Simgag-MinEnv/DEHCam/Extras/HW/imgs/20210331_120226.jpg

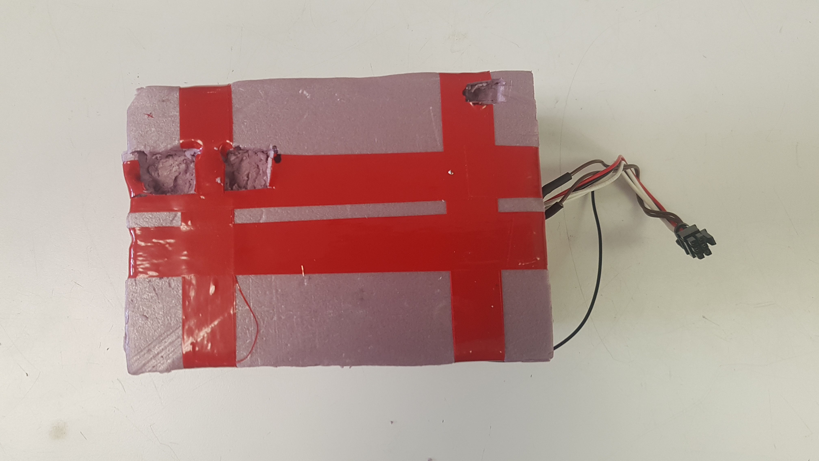
Extras/HW/imgs/20210331_120226.jpg
