Simgag-MinEnv/DEHCam/Extras/HW/imgs/20210331_115955.jpg

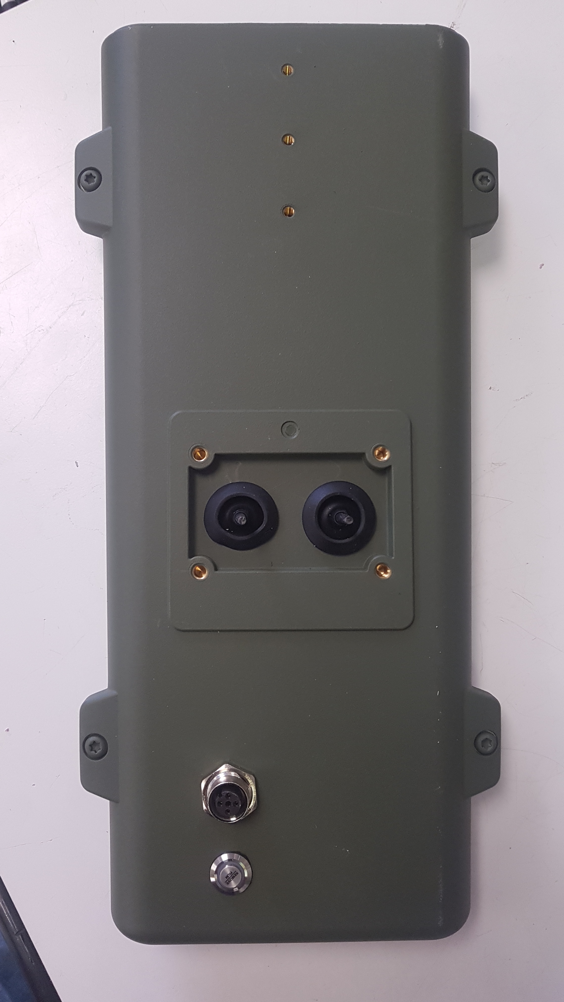
Extras/HW/imgs/20210331_115955.jpg
