Simgag-MinEnv/DEHCam/README.md

# DEHCam
A fully autonomous LTE field camera
