Simgag-MinEnv/DEHCam/Extras/HW/imgs/20210331_115628.jpg

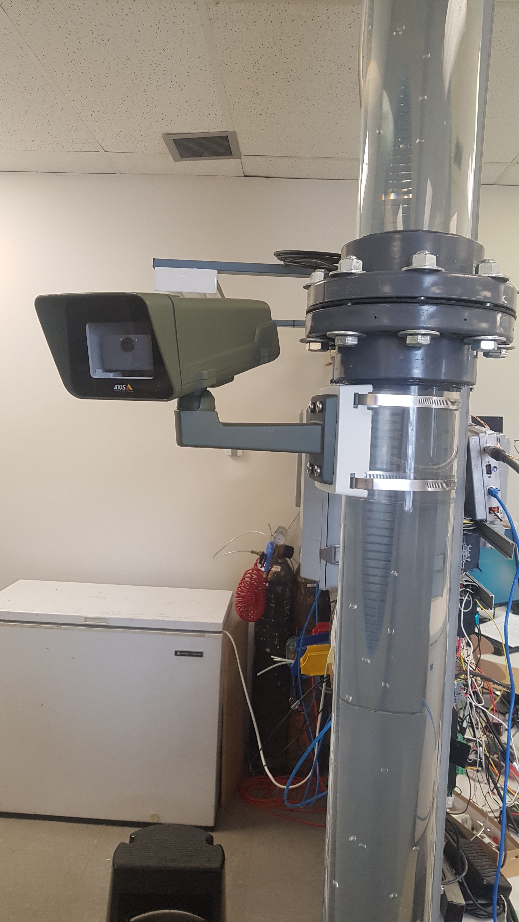
Extras/HW/imgs/20210331_115628.jpg
