Simgag-MinEnv/DEHCam/Extras/HW/imgs/20210331_115636.jpg

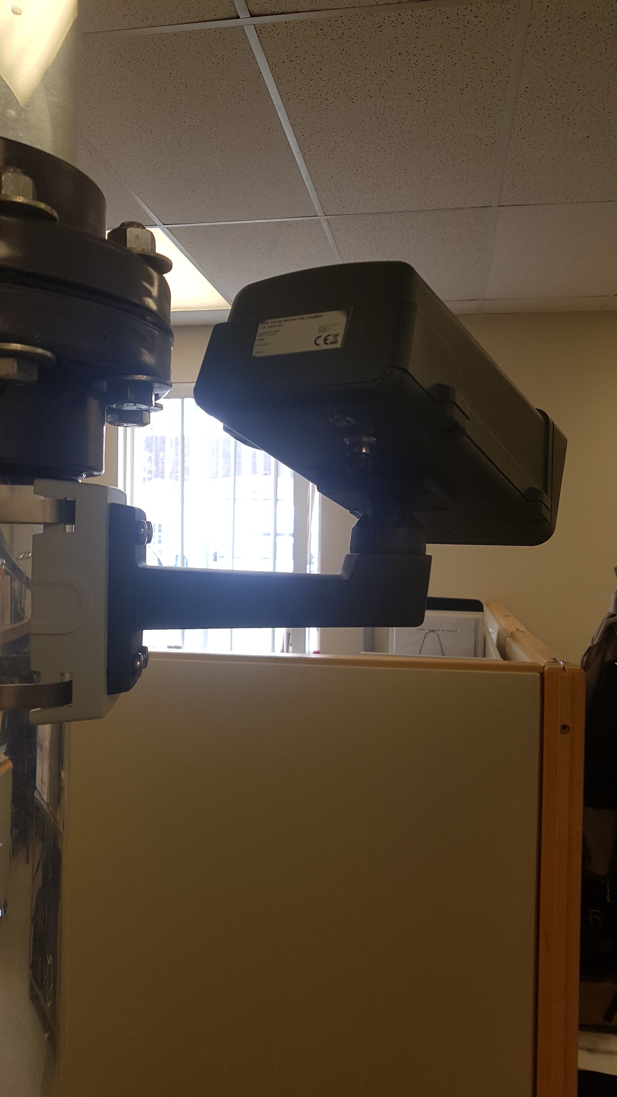
Extras/HW/imgs/20210331_115636.jpg
