Simgag-MinEnv/DEHCam/Extras/HW/imgs/20210331_115641.jpg

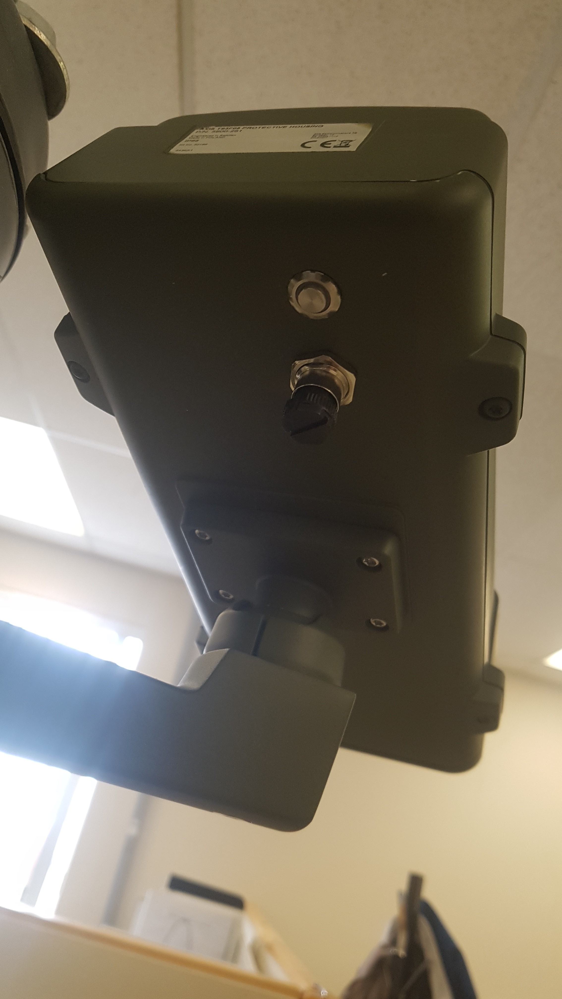
Extras/HW/imgs/20210331_115641.jpg
