Simgag-MinEnv/DEHCam/Extras/HW/imgs/20210331_115650.jpg

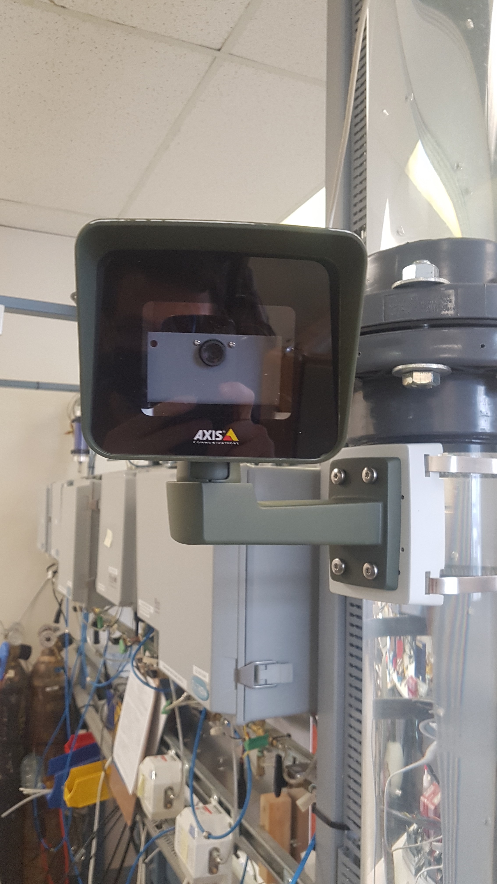
Extras/HW/imgs/20210331_115650.jpg
