Simgag-MinEnv/DEHCam/Extras/HW/imgs/20210331_120000.jpg

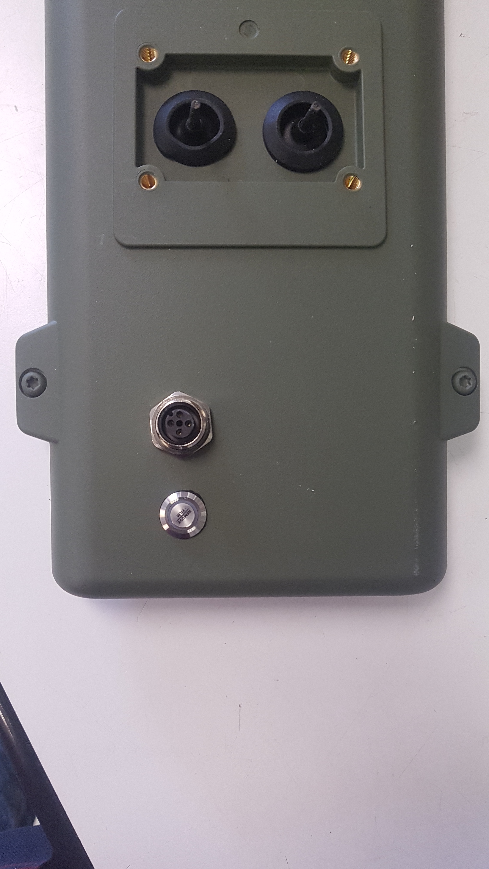
Extras/HW/imgs/20210331_120000.jpg
