Simgag-MinEnv/DEHCam/Extras/HW/imgs/20210331_120005.jpg

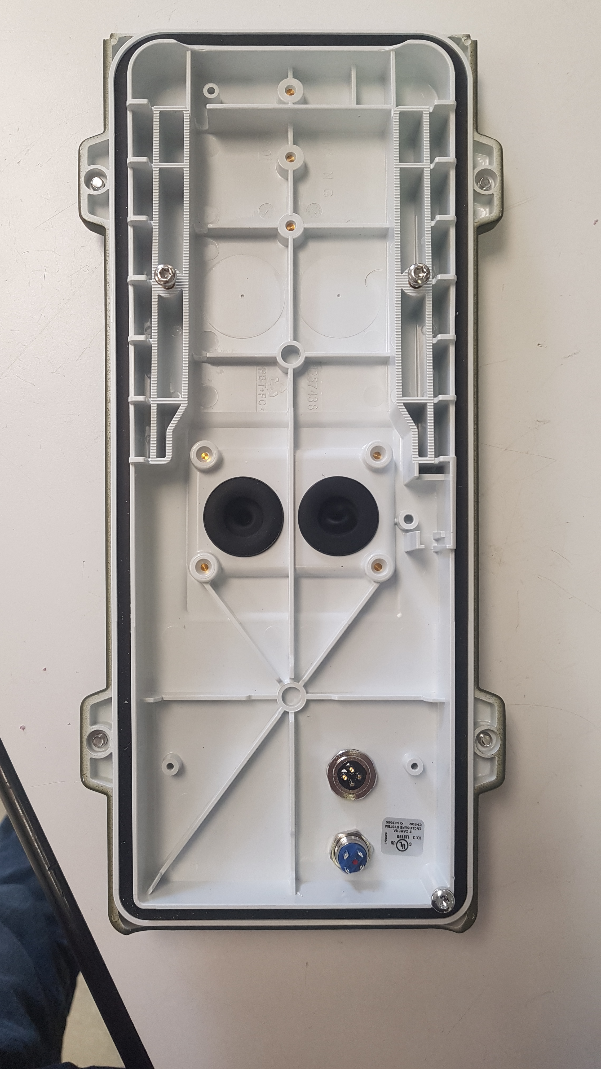
Extras/HW/imgs/20210331_120005.jpg
