Simgag-MinEnv/DEHCam/Extras/HW/imgs/20210331_120015.jpg

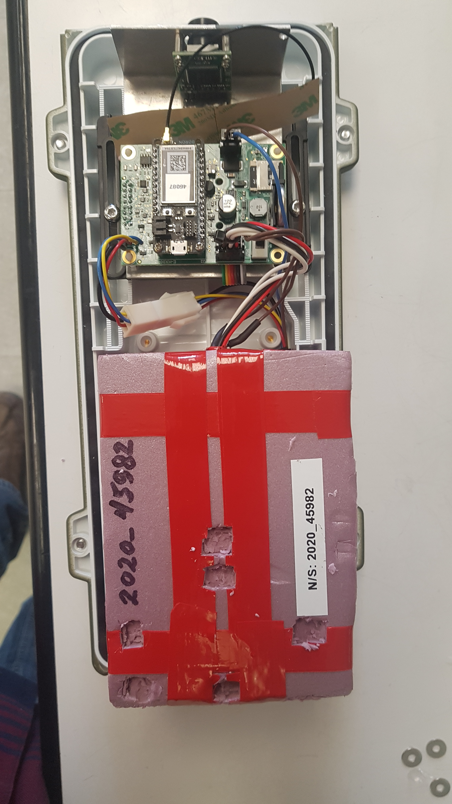
Extras/HW/imgs/20210331_120015.jpg
