Simgag-MinEnv/DEHCam/Extras/HW/imgs/20210331_120052.jpg

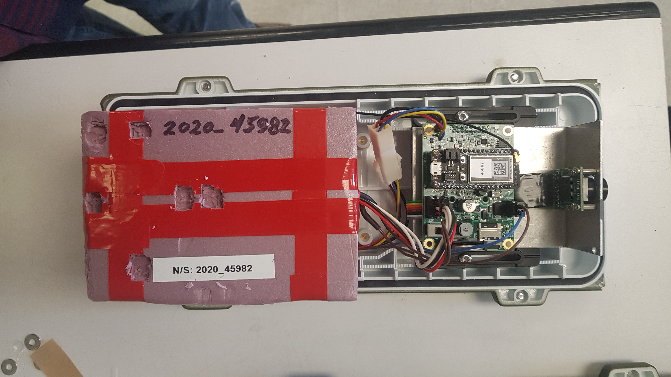
Extras/HW/imgs/20210331_120052.jpg
