Simgag-MinEnv/DEHCam/Extras/HW/imgs/20210331_120108.jpg

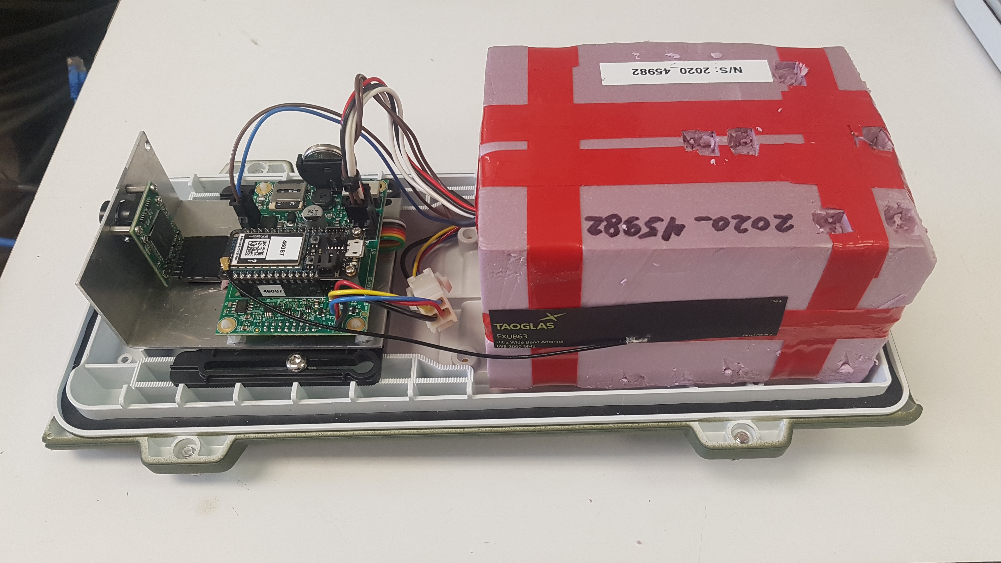
Extras/HW/imgs/20210331_120108.jpg
