Simgag-MinEnv/DEHCam/Extras/HW/imgs/20210331_120122.jpg

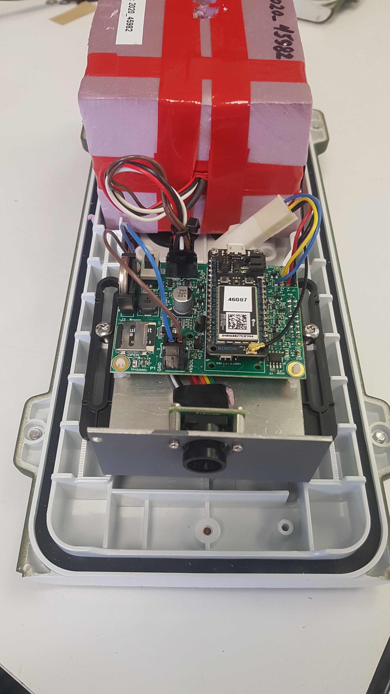
Extras/HW/imgs/20210331_120122.jpg
