Simgag-MinEnv/DEHCam/Extras/HW/imgs/20210331_120146.jpg

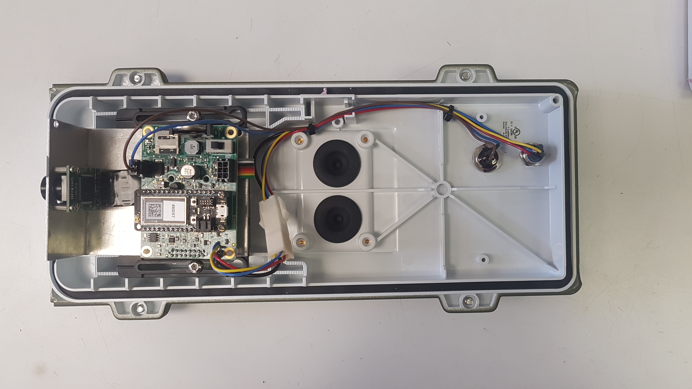
Extras/HW/imgs/20210331_120146.jpg
