Simgag-MinEnv/DEHCam/Extras/HW/imgs/20210331_120150.jpg

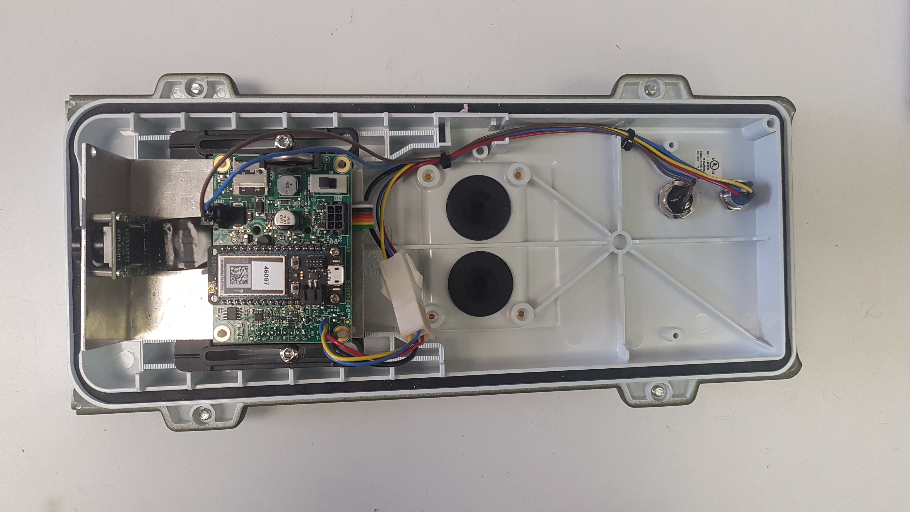
Extras/HW/imgs/20210331_120150.jpg
