Simgag-MinEnv/DEHCam/Extras/HW/imgs/20210331_120212.jpg

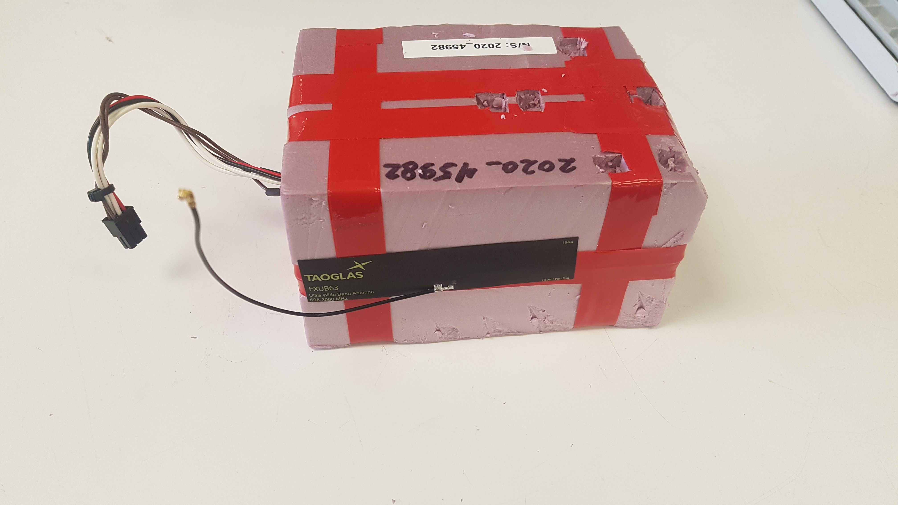
Extras/HW/imgs/20210331_120212.jpg
