Simgag-MinEnv/DEHCam/Extras/HW/imgs/20210331_120219.jpg

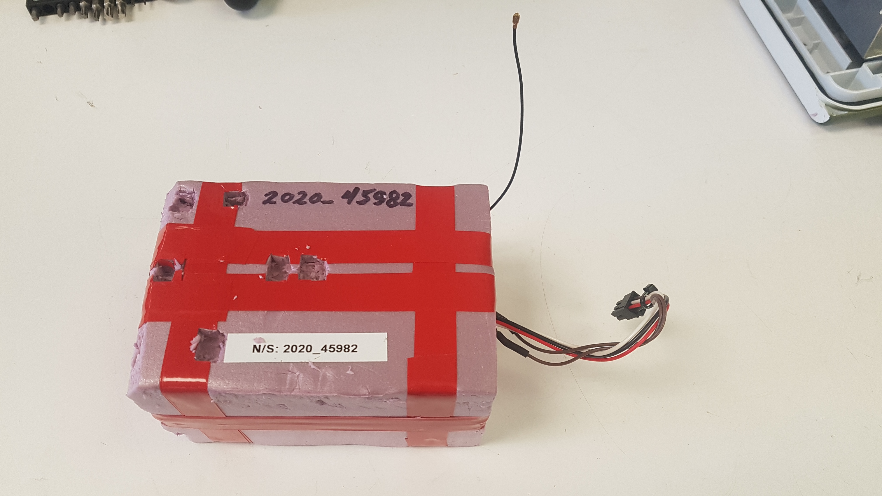
Extras/HW/imgs/20210331_120219.jpg
