Simgag-MinEnv/DEHCam/Extras/HW/imgs/20210331_150757.jpg

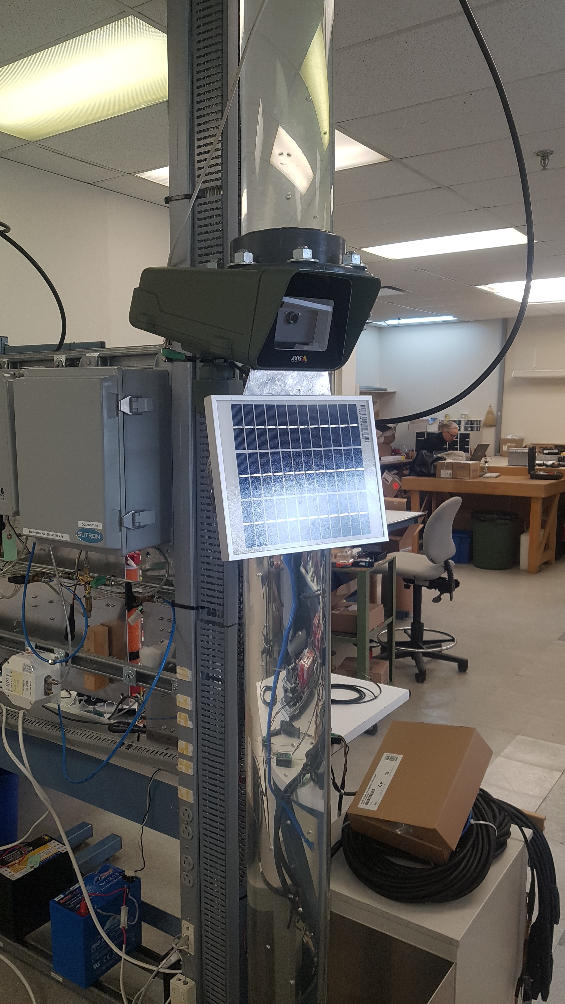
Extras/HW/imgs/20210331_150757.jpg
