Simgag-MinEnv/DEHCam/Extras/HW/imgs/20210331_150813.jpg

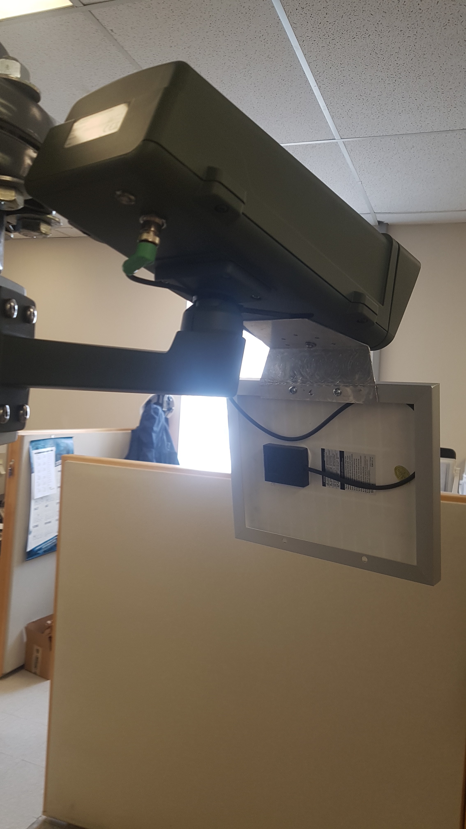
Extras/HW/imgs/20210331_150813.jpg
