Simgag-MinEnv/DEHCam/Extras/Man/Fr/img/BattAssy.png

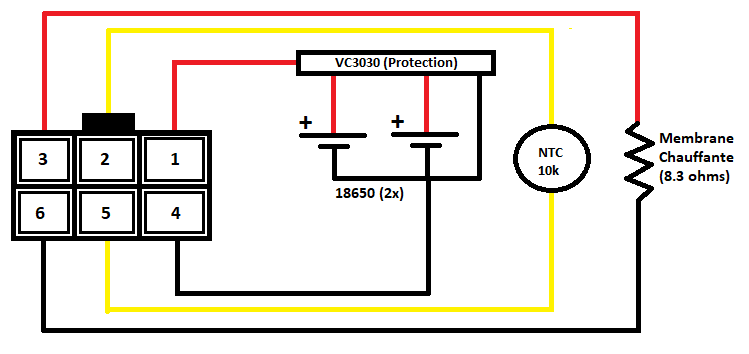
Extras/Man/Fr/img/BattAssy.png
