Simgag-MinEnv/DEHCam/Extras/Man/Fr/img/Boron_SIM.jpg

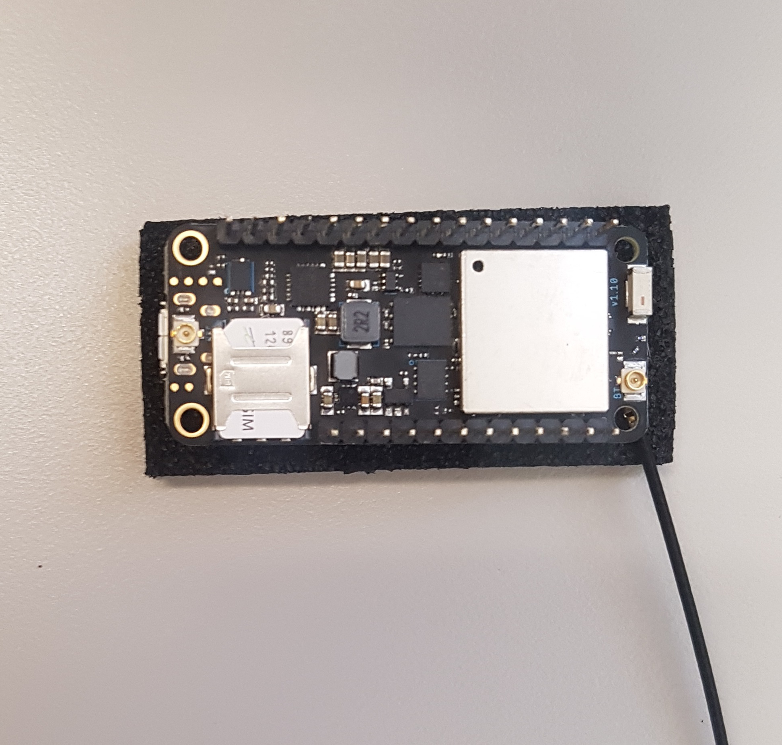
Extras/Man/Fr/img/Boron_SIM.jpg
