Simgag-MinEnv/DEHCam/Extras/Man/Fr/img/BoronBelow.jpg

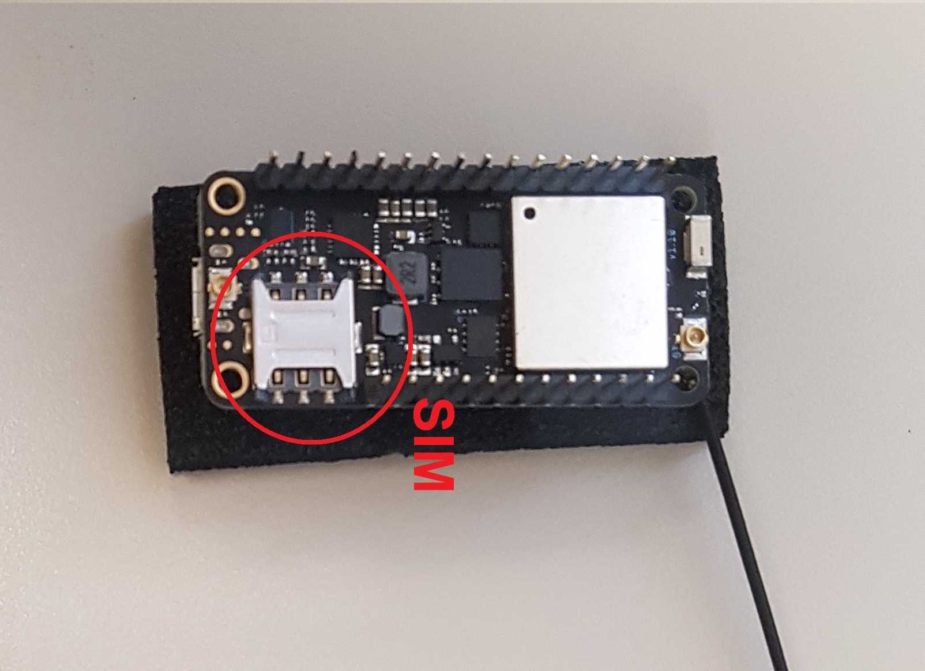
Extras/Man/Fr/img/BoronBelow.jpg
