Simgag-MinEnv/DEHCam/Extras/Man/Fr/img/Cam_final.jpg

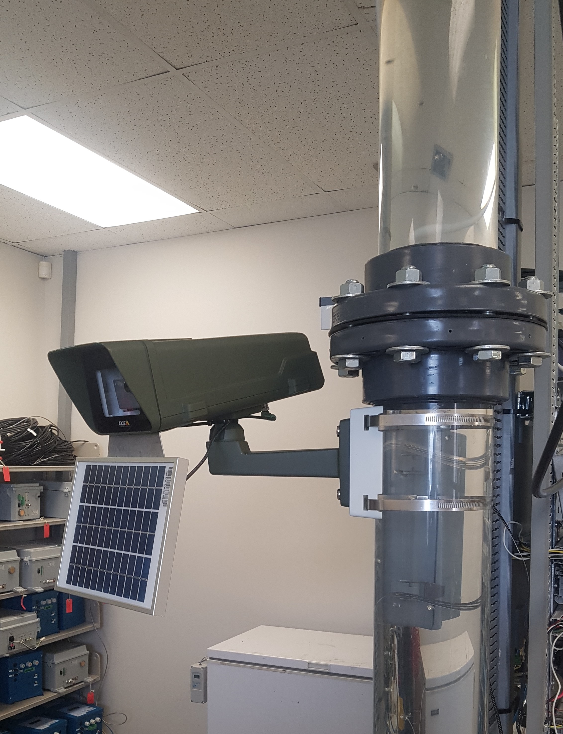
Extras/Man/Fr/img/Cam_final.jpg
