Simgag-MinEnv/DEHCam/Extras/Man/Fr/img/CloudDeviceDetail.png

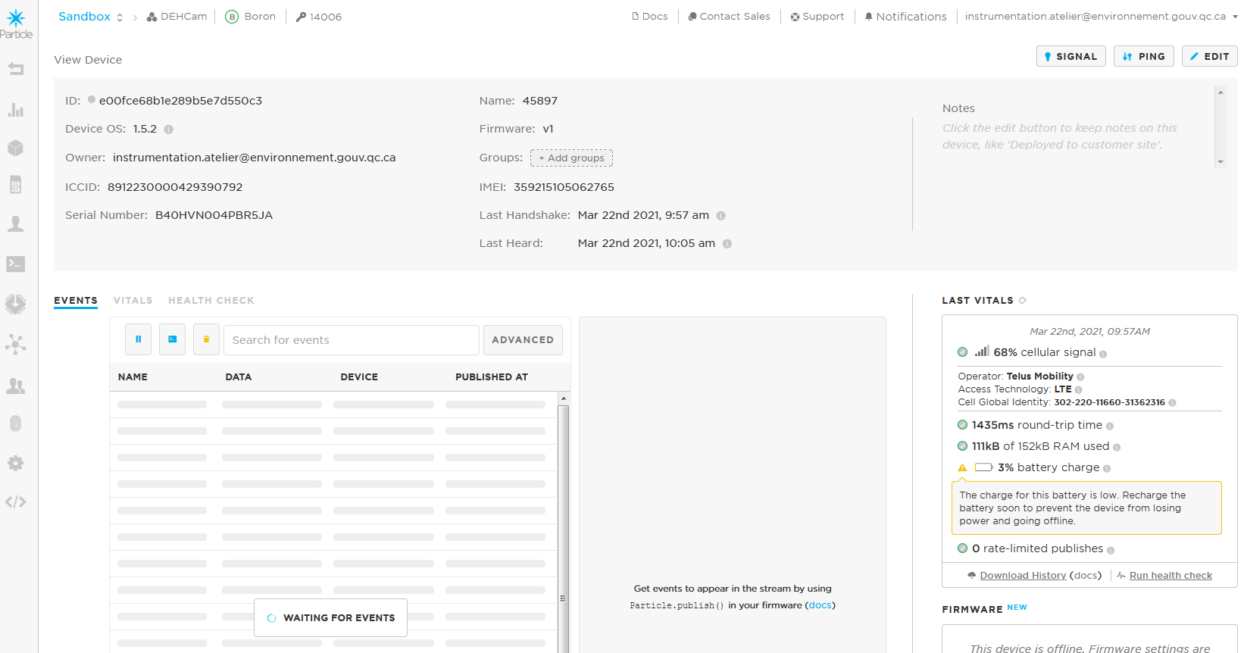
Extras/Man/Fr/img/CloudDeviceDetail.png
