Simgag-MinEnv/DEHCam/Extras/Man/Fr/img/CloudDevices.png

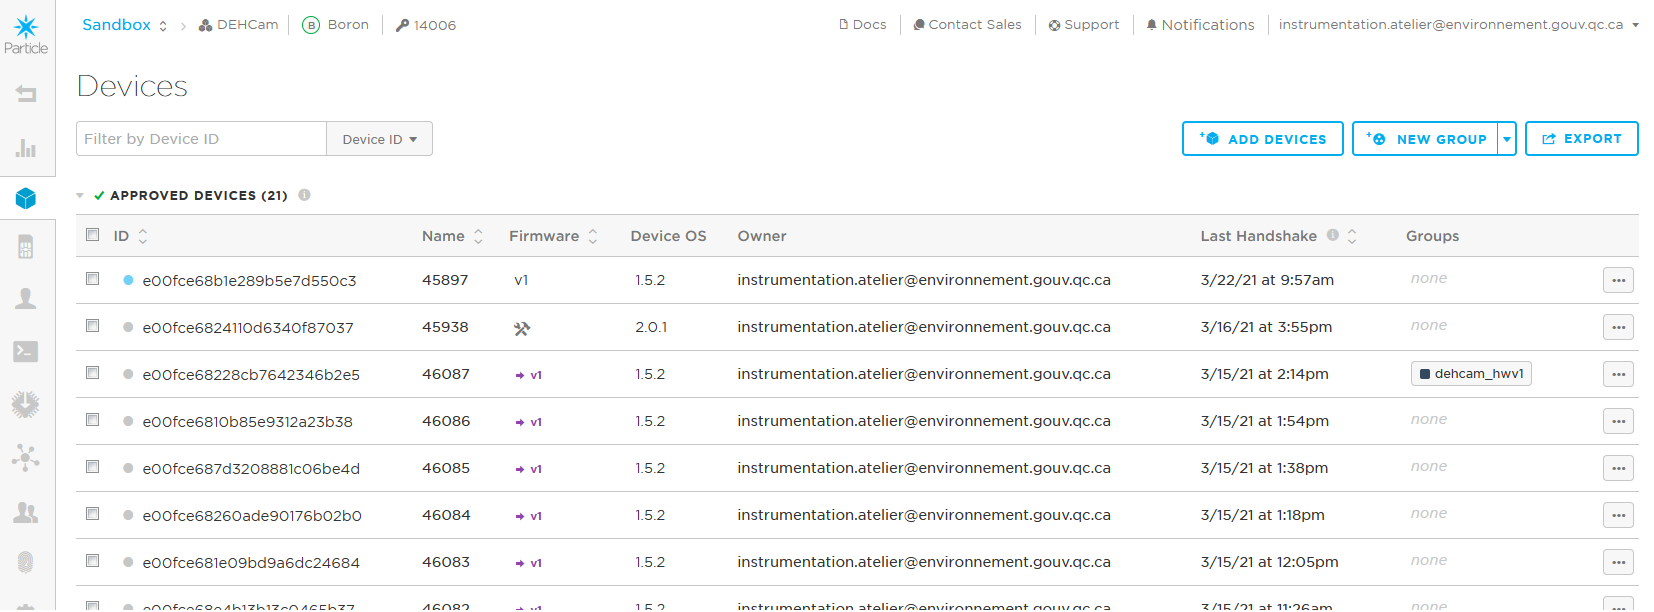
Extras/Man/Fr/img/CloudDevices.png
