Simgag-MinEnv/DEHCam/Extras/Man/Fr/img/CloudFirmwares.png

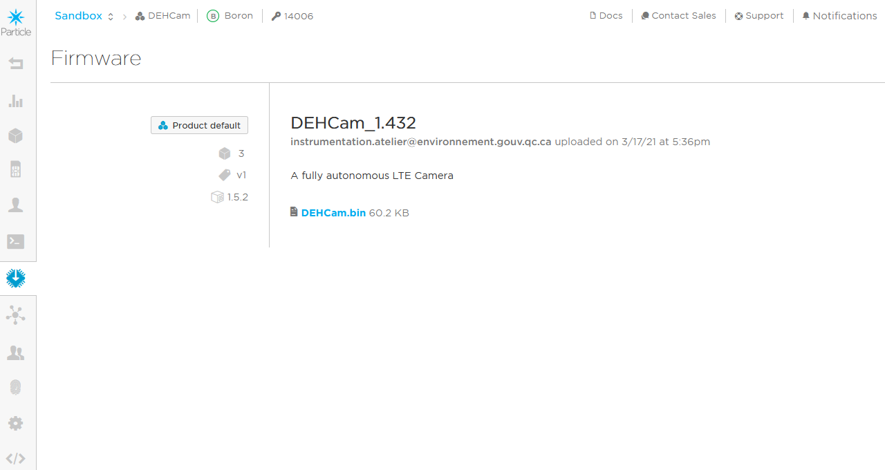
Extras/Man/Fr/img/CloudFirmwares.png
