Simgag-MinEnv/DEHCam/Extras/Man/Fr/img/CloudProducts.png

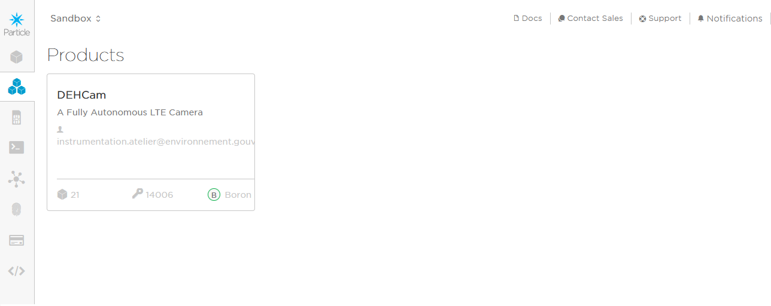
Extras/Man/Fr/img/CloudProducts.png
