Simgag-MinEnv/DEHCam/Extras/Man/Fr/img/CloudUsers.png

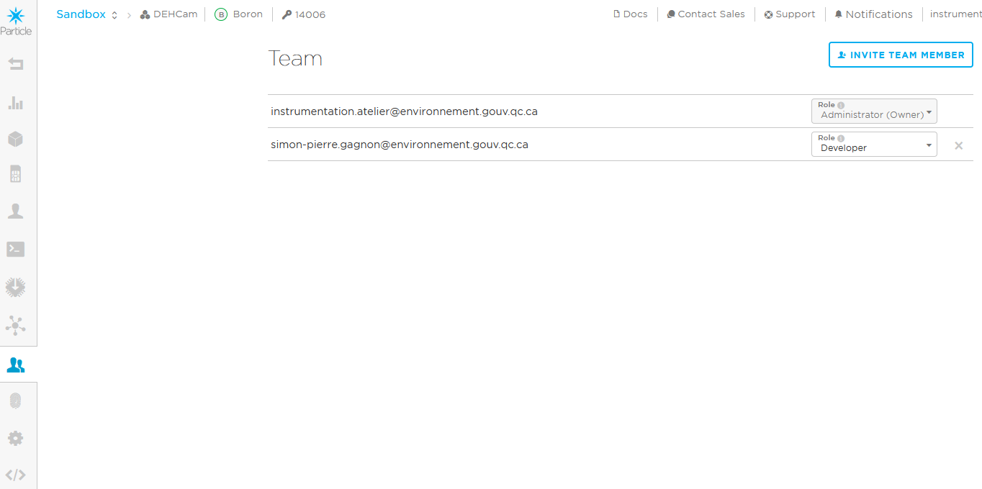
Extras/Man/Fr/img/CloudUsers.png
