Simgag-MinEnv/DEHCam/Extras/Man/Fr/img/exif.png

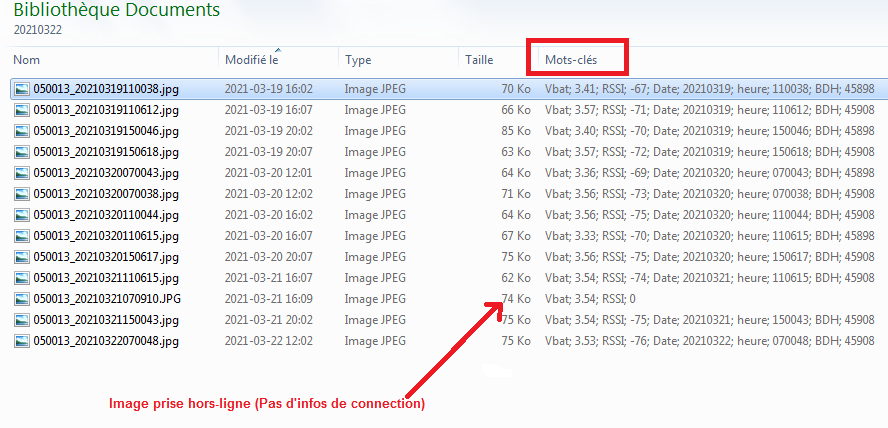
Extras/Man/Fr/img/exif.png
