Simgag-MinEnv/DEHCam/Extras/Man/Fr/img/IAM.PNG

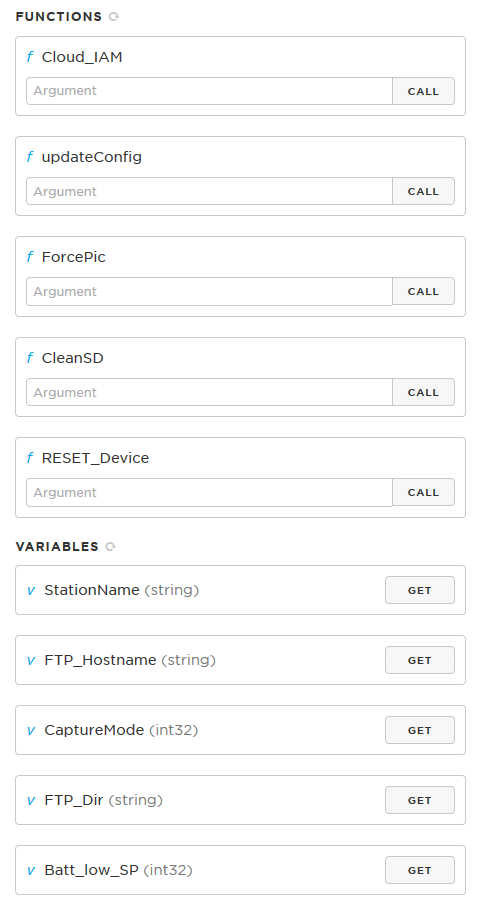
Extras/Man/Fr/img/IAM.PNG
