Simgag-MinEnv/DEHCam/Extras/Man/Fr/img/MB_1.png

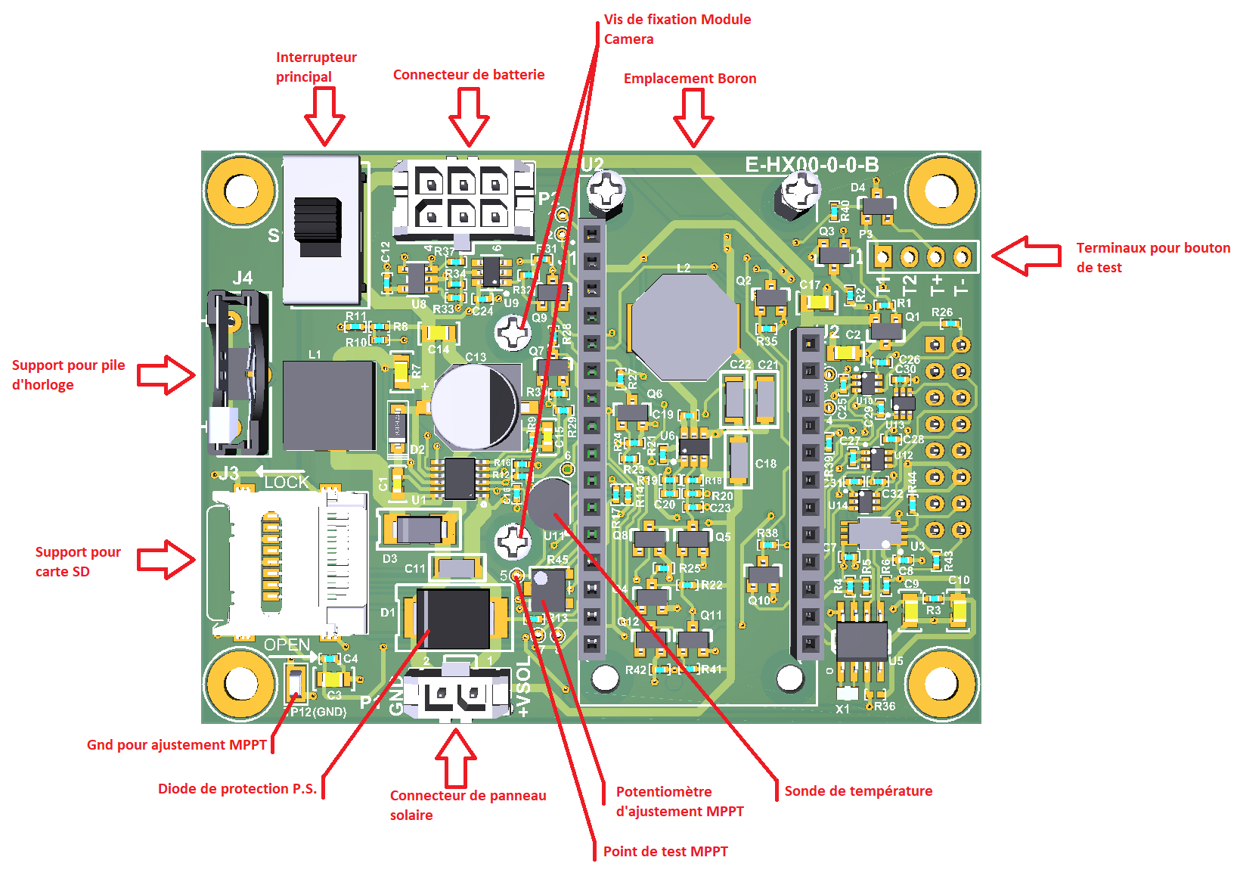
Extras/Man/Fr/img/MB_1.png
