Simgag-MinEnv/DEHCam/Extras/Man/Fr/img/MB_2.png

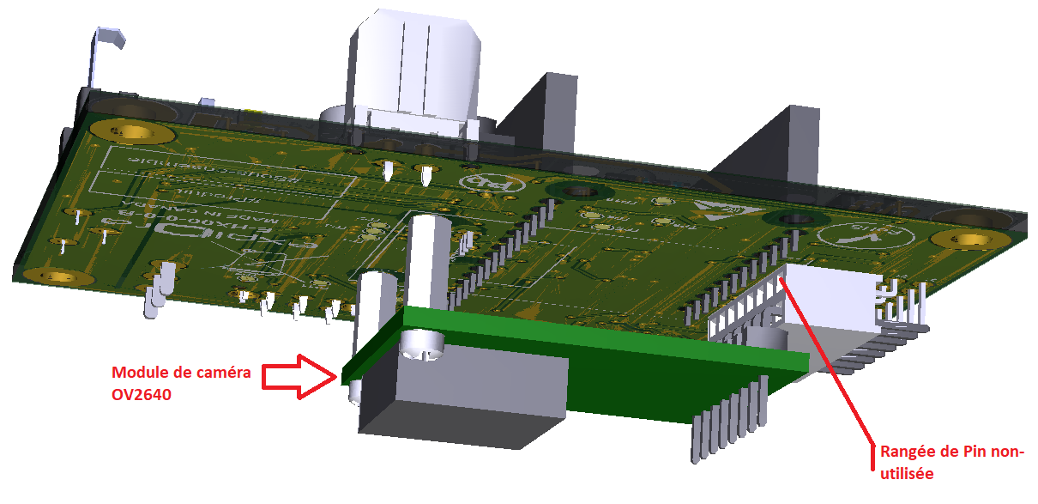
Extras/Man/Fr/img/MB_2.png
