Simgag-MinEnv/DEHCam/Extras/Man/Fr/img/Percements_boitier.jpg

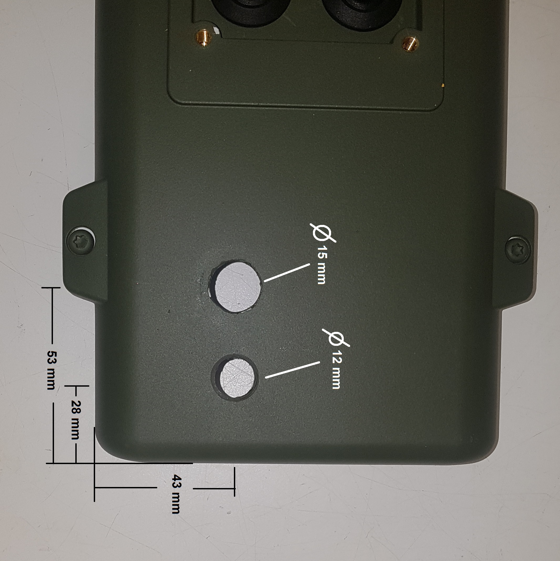
Extras/Man/Fr/img/Percements_boitier.jpg
