Simgag-MinEnv/DEHCam/Extras/Man/Fr/img/PlaqueSupport.png

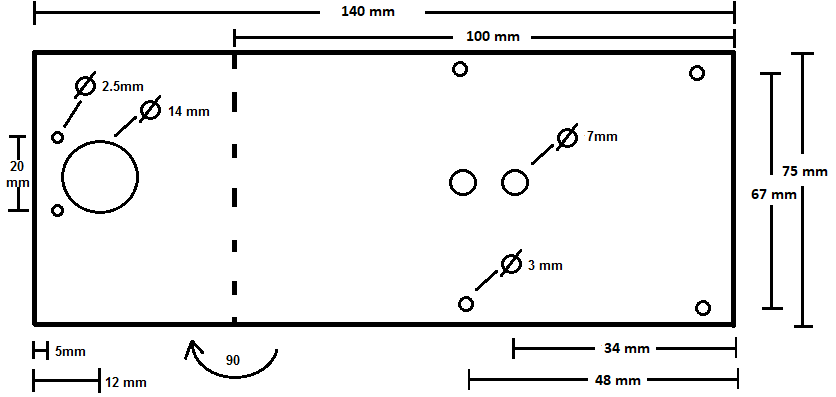
Extras/Man/Fr/img/PlaqueSupport.png
