Simgag-MinEnv/DEHCam/Extras/Man/Fr/img/schema_fonctionnel.jpg

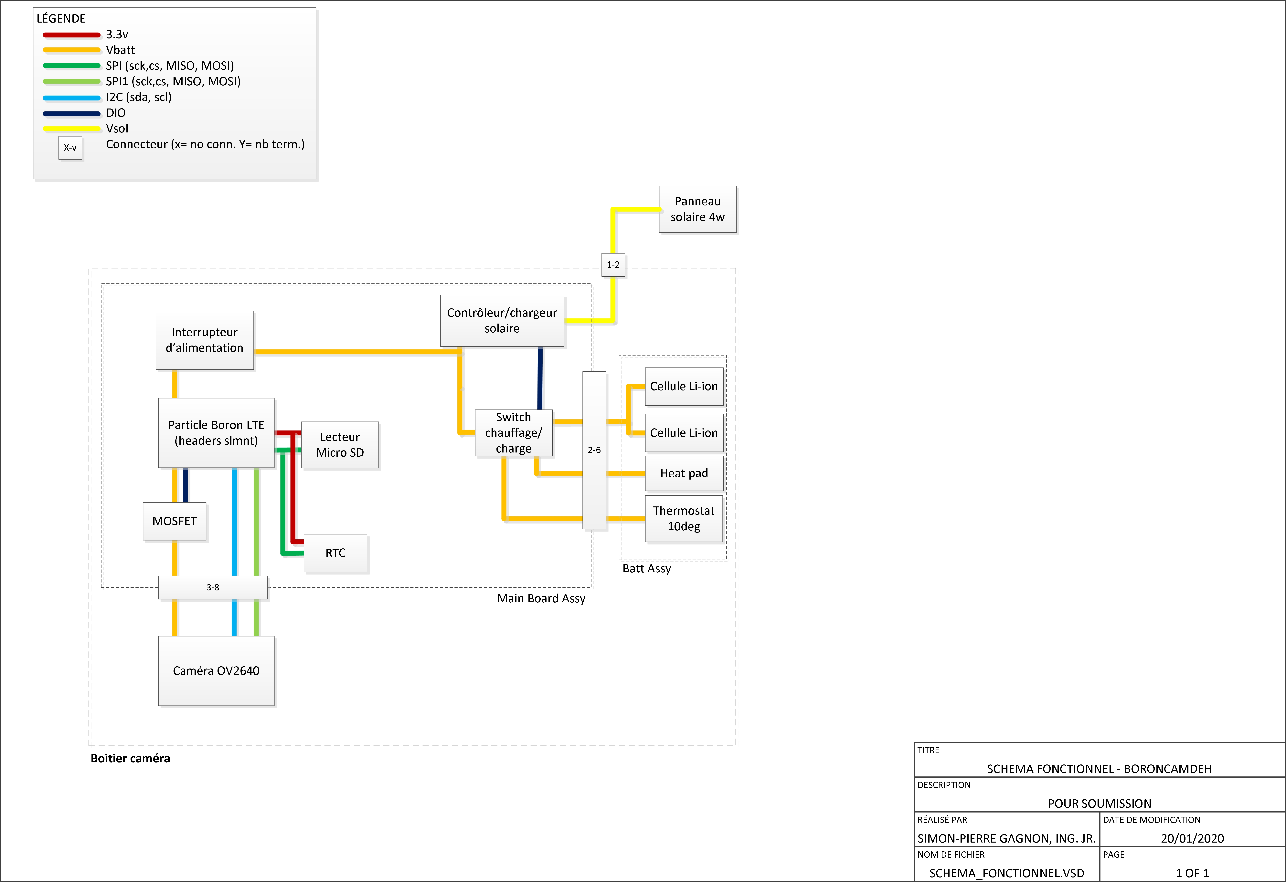
Extras/Man/Fr/img/schema_fonctionnel.jpg
