Simgag-MinEnv/DEHCam/Extras/Man/Fr/img/Support PS.jpg

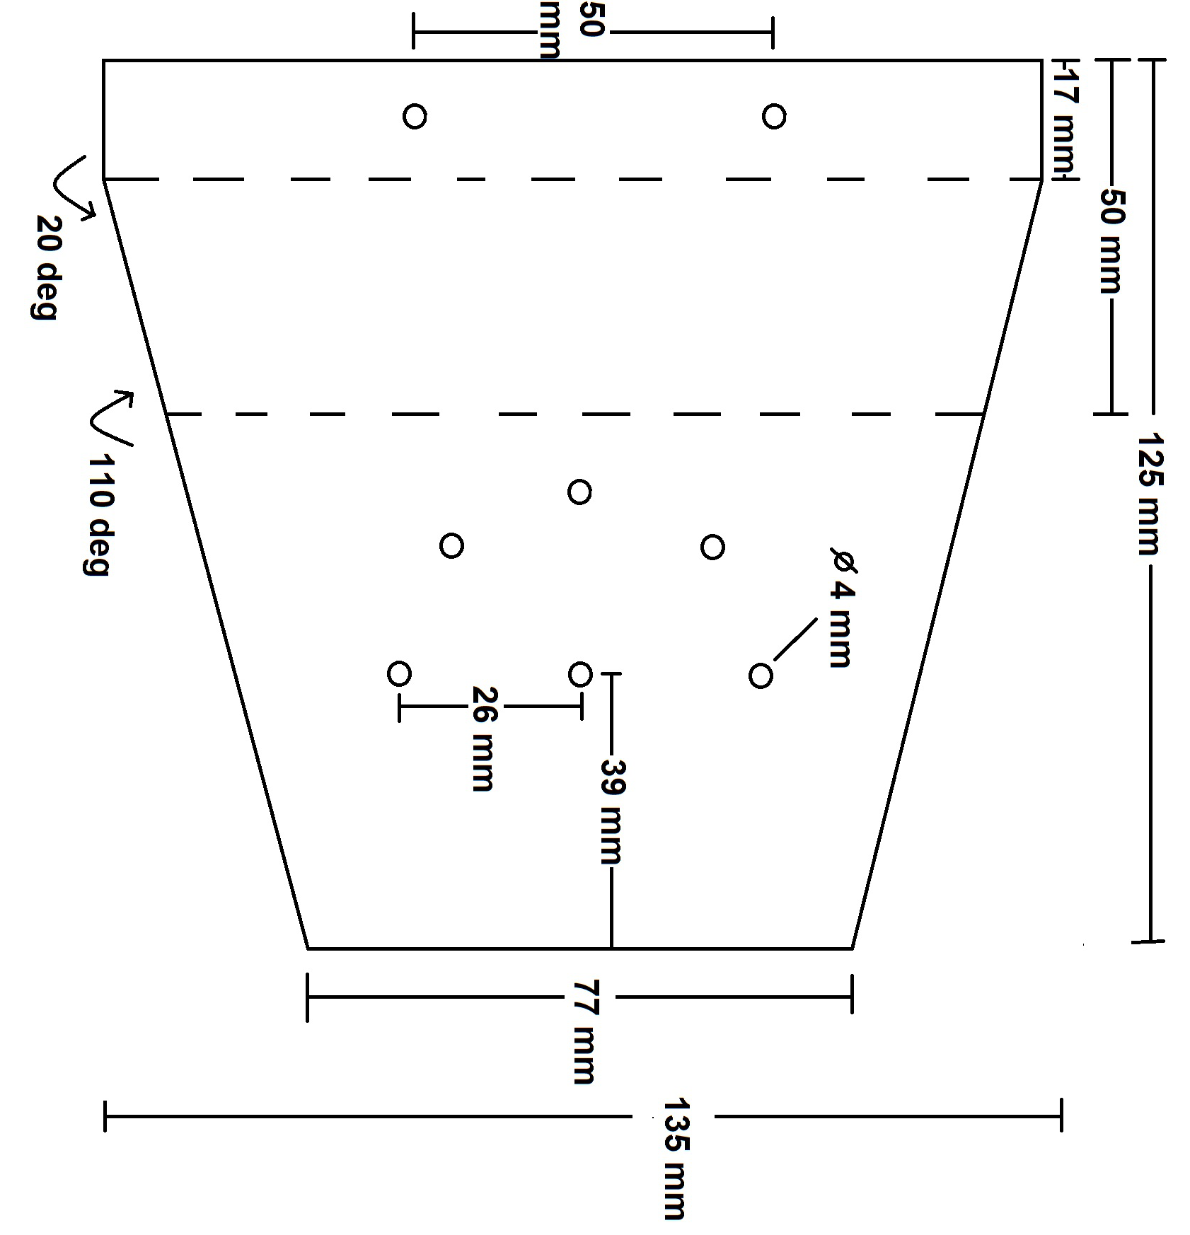
Extras/Man/Fr/img/Support PS.jpg
