Simgag-MinEnv/DEHCam/Extras/Man/Fr/img/TypLog.png

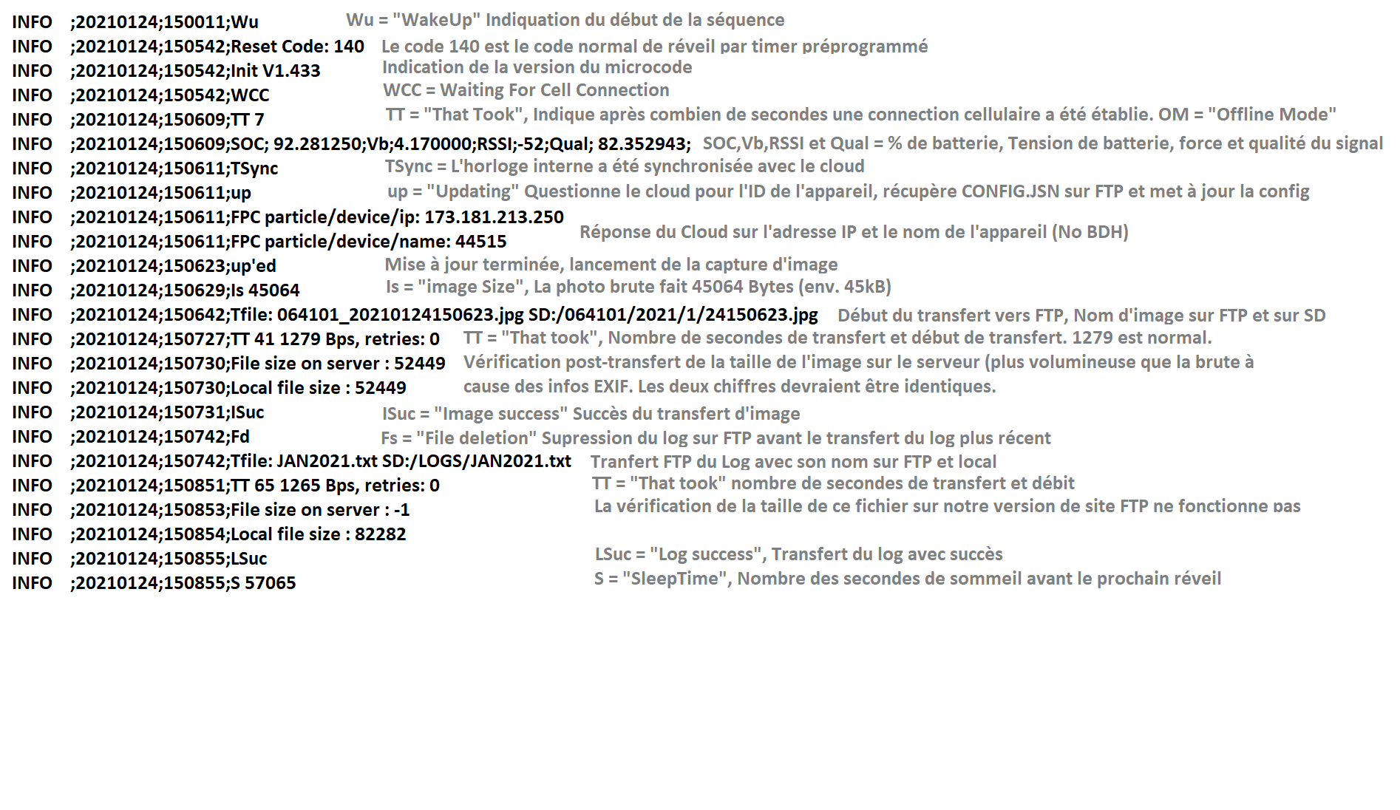
Extras/Man/Fr/img/TypLog.png
