Simgag-MinEnv/DEHCam/Extras/Man/Fr/img/VScode.png

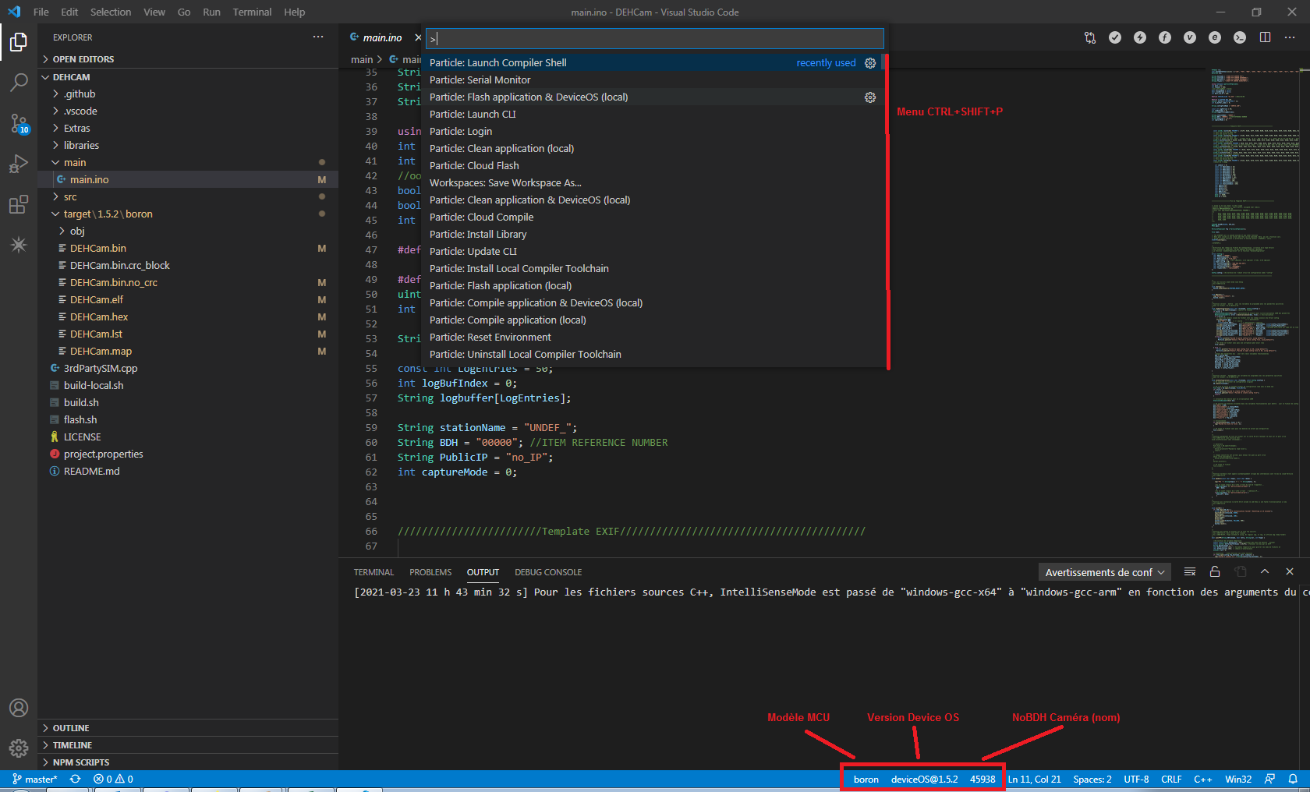
Extras/Man/Fr/img/VScode.png
