Simgag-MinEnv/DEHCam/Extras/HW/Bom_8071126.xlsx

Sheet: BOM_2020-09-11
Item | Description | Fournisseur | Modèle | prix u | qté | total | Commentaire
Main Board | Plaquette principale | Explora | SS-E-HX00-1 REV:0 | 250.00 $ | 1 | 250.00 $
MCU | Particle boron LTE | Digi-Key | BRN402 | 78.26 $ | 1 | 78.26 $ | Boron Inclus Antenne TAOGLAS
Batt | custom | BBM |  | 50.00 $ | 1 | 50.00 $
PS | Panneau solaire 10w | Crobel | EWS-10P | 56.00 $ | 1 | 56.00 $
HM | Heat mat | RobotShop | COM-11289 | 5.95 $ | 1 | 5.95 $ | version 5x15cm, 5x10 aussi dispo.
divers | filage connecteur etc | divers |  | 40.00 $ | 1 | 40.00 $
Caméra | OV2640 Arducam | RobotShop | B0067 | 35.35 $ | 1 | 35.35 $ | OV2640 2MP PLUS
Boitier | Boitier T93F05 | Anixter | 5900-261 | 215.00 $ | 1 | 215.00 $ | Boitier IP68
PB | Bouton poussoir SS | Digi-Key | PV0H240SS-311 | 16.68 $ | 1 | 16.68 $ | Bouton rouge
Molex-2 | Connecteur pour P.S. | Digi-Key | 436450200 | 0.46 $ | 1 | 0.46 $
Pin-F | Pin femelle pour conn. Molex | Digi-Key | 430300002 | 0.24 $ | 4 | 0.96 $ | 20-24 AWG
 |  |  |  |  | Total | 748.66 $

Sheet: Amortissement
Frais fixe de développement
9000 | Dév
800 | 2 protos
400 | pièces proto
Item | description | fournisseur | prix u | qté | total
Main Board | Plaquette principale | Explora | 250.00 $ | 1 | 250.00 $
MCU | Particle boron LTE | Digi-Key | 78.26 $ | 1 | 78.26 $
Batt | custom | BBM | 50.00 $ | 1 | 50.00 $
PS | Panneau solaire 10w | Crobel | 56.00 $ | 1 | 56.00 $
HM | Heat mat | RobotShop | 5.95 $ | 1 | 5.95 $
divers | filage connecteur etc | divers | 40.00 $ | 1 | 40.00 $
Caméra | OV2640 Arducam | RobotShop | 35.35 $ | 1 | 35.35 $
Boitier | Boitier T93F05 | Anixter | 215.00 $ | 1 | 215.00 $
PB | Bouton poussoir SS | Digi-Key | 16.68 $ | 1 | 16.68 $
Molex-2 | Connecteur pour P.S. | Digi-Key | 0.46 $ | 1 | 0.46 $
Pin-F | Pin femelle pour conn. Molex | Digi-Key | 0.24 $ | 4 | 0.96 $
 |  |  |  | Total | 748.66 $
 | Qtée commandée | prix de revient
 | 1 | 10948.66 $
 | 5 | 2788.66 $
 | 10 | 1768.66 $
 | 15 | 1428.66 $
 | 20 | 1258.66 $
 | 25 | 1156.66 $
 | 30 | 1088.66 $
 | 35 | 1040.09 $
 | 40 | 1003.66 $
 | 45 | 975.33 $
 | 50 | 952.66 $
