Simgag-MinEnv/DEHCam/Extras/HW/PCB/REVB/BOM HX000-0-0-B 2021-03-16.xlsx

Qty | P/N | Detail | Ref(m) | Mfr | Mfr-P/N
1 | DOS012 | DIODE SCHOTTKY 40V 3A SMA | D3 | DIODES INCORPORATED | B340A-13-F
1 | DOS022 | DIODE SCHOTTKY 40V 1A SOD123 | D2 | DIODES INCORPORATED | 1N5819HW-7-F
1 | DTS011 | TVS ESD UNIDIR DUAL 3.3V SOT23 | D4 | VISHAY | GSOT03C-E3-08
1 | DZS044 | DIODE TVS 33V 3000W 5% BI SMD | D1 | LITTELFUSE | SMDJ33CA
1 | FBO103-15 | INDUCTOR POWER 10UH 3.0A | L2 | Wurth Electronics Inc | 744065100
1 | FBO153-13 | FIXED IND 15UH 3.5A 52.8 MOHM | L1 | MURATA | DD1217AS-H-150M=P3
1 | FIS004 | SWITCH SLIDE SPDT 3A 125V | S1 | NKK SWITCH | CS12ANW03
1 | FSO020 | BATTERY HOLDER COIN PC PIN | J4 | EXPLORA | FSO018
1 | FST18B20 | SENSOR DIGITAL -55C-125C TO92-3 1-WIRE | U11 | MAXIM | DS18B20+
1 | FXT032K76800-01 | CRYSTAL 32.768 kHz 12.5pF SMD | X1 | ABRACON LLC | ABS06L-32.768KHZ-T
1 | IAS2381 | OP AMP RAIL TO RAIL IO 1-CH SOT-23-5 | U8 | TEXAS INSTRUMENTS | TLV2381IDBVT
1 | IAS3652-01 | BATTERY CHARGER 2A MPPT 12-MSOP | U1 | ANALOG DEVICES | LT3652EMSE#PBF
1 | IAS3808-01 | VOLT SUPERVISOR ADJ SOT23-6 | U9 | TEXAS INSTRUMENTS | TPS3808G01DBVT
1 | IAS63201 | IC REG BUCK ADJUSTABLE 2A TSOT26 | U6 | DIODES INCORPORATED | AP63201WU-7
1 | IAS9517-01 | LEVEL TRANSLATING I2C-BUS REPEATER | U3 | NXP | PCA9517DP,118
4 | IDS741T45 | IC TRNSLTR BIDIRECTIONAL 6TSSOP | U10, U12, U13, U14 | NEXPERIA | 74LVCH1T45GW,125
1 | IDS8523 | IC RTC CLK/CALENDAR I2C 8-SOIC | U5 | NXP | PCF8523T/1,118
2 | KCS101-02 | CAP CER 100PF 50V 5% NPO | C16, C20 | KEMET | C0402C101J5GACTU
15 | KCS104-04 | CAP .1UF 16V CERAMIC X7R 0402 | C4, C7, C8, C12, C19, C23, C24, C25, C26, C27, C28, C29, C30, C31, C32 | MURATA | GRM155R71C104KA88D
1 | KCS105-11 | CAP CER 1UF 50V 10% X7R 0603 | C1 | TAIYO YUDEN | UMK107AB7105KA-T
2 | KCS106-06 | CAP CER 10UF 35V X5R 10% 1206 | C11, C18 | TAIYO YUDEN | GMK316BJ106KL-T
6 | KCS106-12 | CAP CER 10UF 16V 10% X5R 0805 | C2, C3, C9, C10, C14, C17 | TDK Corporation | C2012X5R1C106K085AC
2 | KCS226-03 | CAP CER 22UF 16V 20% X5R 1206 | C21, C22 | SAMSUNG | CL31A226MOHNNNE
1 | KCS475-01 | CAP CER 4.7UF 6.3V 15% X5R 0603 | C15 | SAMSUNG | CL10A475KQ8NNNC
1 | KES107-02 | CAP ELECT 100UF 50V FK SMD | C13 | PANASONIC | EEE-FK1H101P
1 | NFD141 | CONN HDR 16POS 0.1 GOLDPCB (16x1) | J1 | Sullins Connector Solutions | PPPC161LFBN-RC
1 | NFD142 | CONN HDR 12POS 0.1 GOLD PCB (12x1) | J2 | Sullins Connector Solutions | PPPC121LFBN-RC
1 | NFD143 | CONN HDR 16POS 0.1 GOLD PCB R/A (8x2) | J5 | Sullins Connector Solutions | PPPC082LJBN-RC
1 | NFS056 | Connecteur MicroSD Hinge | J3 | MOLEX | 500901-0801
1 | NMD185 | CONN HEADER 2POS 3MM VERT TIN MICROFIT 3.0 | P1 | MOLEX | 0436500215
1 | NMD187 | 6 POS (3x2) Header, Shrouded Connector (3.00mm) TH Tin | P2 | MOLEX | 43045-0624
1 | NMS087 | SURFACE MOUNT TEST POINTS | TP12 | Keystone | 5015
2 | RFS0000-0B | RES 0R 1/16W SMT C=0402 | R9, R37 | YAGEO | RC0402JR-070RL
1 | RFS1001-1B | RES 100R 1/16W 1% SMT C=0402 | R2 | YAGEO | RC0402FR-07100RL
1 | RFS1002-1B | RES 1.0K OHM 1/16W 1% | R3 | YAGEO | RC0402FR-071KL
11 | RFS1003-1B | RES 10K OHM 1/16W 1% | R4, R5, R6, R20, R26, R34, R35, R38, R39, R43, R44 | YAGEO | RC0402FR-0710KL
14 | RFS1004-1B | RES 100K OHM 1/16W 1% | R1, R16, R22, R23, R24, R25, R27, R28, R29, R30, R31, R32, R41, R42 | YAGEO | RC0402FR-07100KL
1 | RFS1005-1B | RES 1.00M OHM 1/16W 1% | R12 | YAGEO | RC0402FR-071ML
1 | RFS1104-1B | RES 110K OHM 1/16W 1% 0402 SMD | R18 | VISHAY | CRCW0402110KFKED
1 | RFS1243-1B | RES 12.4K OHM 1/16W 1% 0402 SMD | R33 | YAGEO | RC0402FR-0712K4L
1 | RFS1584-1B | RES 158K OHM 1/16W 1% 0402 SMD | R19 | PANASONIC | ERJ-2RKF1583X
1 | RFS1804-1B | RES SMD 180K OHM 1% 1/10W 0402 | R10 | PANASONIC | ERJ-2RKF1803X
1 | RFS2001-1B | RES 200 OHM 1/16W 1% 0402 | R40 | YAGEO | RC0402FR-07200RL
1 | RFS3013-1B | RES 30.1K OHM 1/16W 1% 0402 SMD | R21 | YAGEO | RC0402FR-0730K1L
1 | RFS3304-1B | RES 330K OHM 1/16W 1% 0402 SMD | R11 | VISHAY | CRCW0402330KFKED
1 | RFS4702-1B | RES 4.70K OHM 1/16W 1% SMD 0402 | R14 | YAGEO | RC0402FR-074K7L
1 | RFS4994-1B | RES 499K OHM 1/16W 1% | R13 | PANASONIC | ERJ-2RKF4993X
1 | RFS5103-1B | RES 51K OHM 1/16W 1% 0402 | R17 | YAGEO | RC0402FR-0751KL
1 | RFS680C-10 | RES 0.068 OHM 1% 1/2W 0805 | R7 | SUSUMU CO LTD | KRL1220E-M-R068-F-T5
1 | RFS9093-1B | RES 90.9K OHM 1/16W 1% 0402 | R8 | YAGEO | RC0402FR-0790K9L
1 | RVS1004-01 | TRIMMER 100K OHM 0.125W SMD | R45 | Nidec Copal Electronics | SM-31TW104
11 | TFS00138 | MOSFET N-CH 50V 3.5 OHM SOT-23 | Q2, Q3, Q4, Q5, Q6, Q7, Q8, Q9, Q10, Q11, Q12 | ON SEMICONDUCTOR | BSS138
1 | TPS2305-01 | MOSFET P-CH 20V 4.2A | Q1 | DIODES INCORPORATED | DMG2305UX-7
1 | FPI021 | BATTERY LITHIUM 3V COIN 12.5MM 48mAH | BT1 | PANASONIC | BR-1225/BN
1 | NBW022 | MICROFIT-3.0 2POS SINGLE ROW FEMALE | J6 | MOLEX | 43645-0200
4 | NFC008 | CRIMP PIN MICROFIT 3.0 FEMALE 20-24 AWG TIN | J7, J8, J9, J10 | MOLEX | 0430300007
2 | QJA437 | HEX STANDOFF F/F 18-8 SS #2-56 7/16'' | H3, H6 | McMASTER-CARR | 91115A814
8 | QVA187-01 | VIS 2-56 Narrow Fillister PH#1 18-8 SS High-Profile, 3/16" | H7, H8, H9, H10,H11, H12, H15, H16 | McMASTER-CARR | 91737A047
2 | QJA312-01 | HEX STANDOFF F/F 18-8 SS #2-56 5/16'' | H1, H2 | McMASTER-CARR | 91115A810
