Simgag-MinEnv/DEHCam/Extras/HW/Testings/recharge1.png

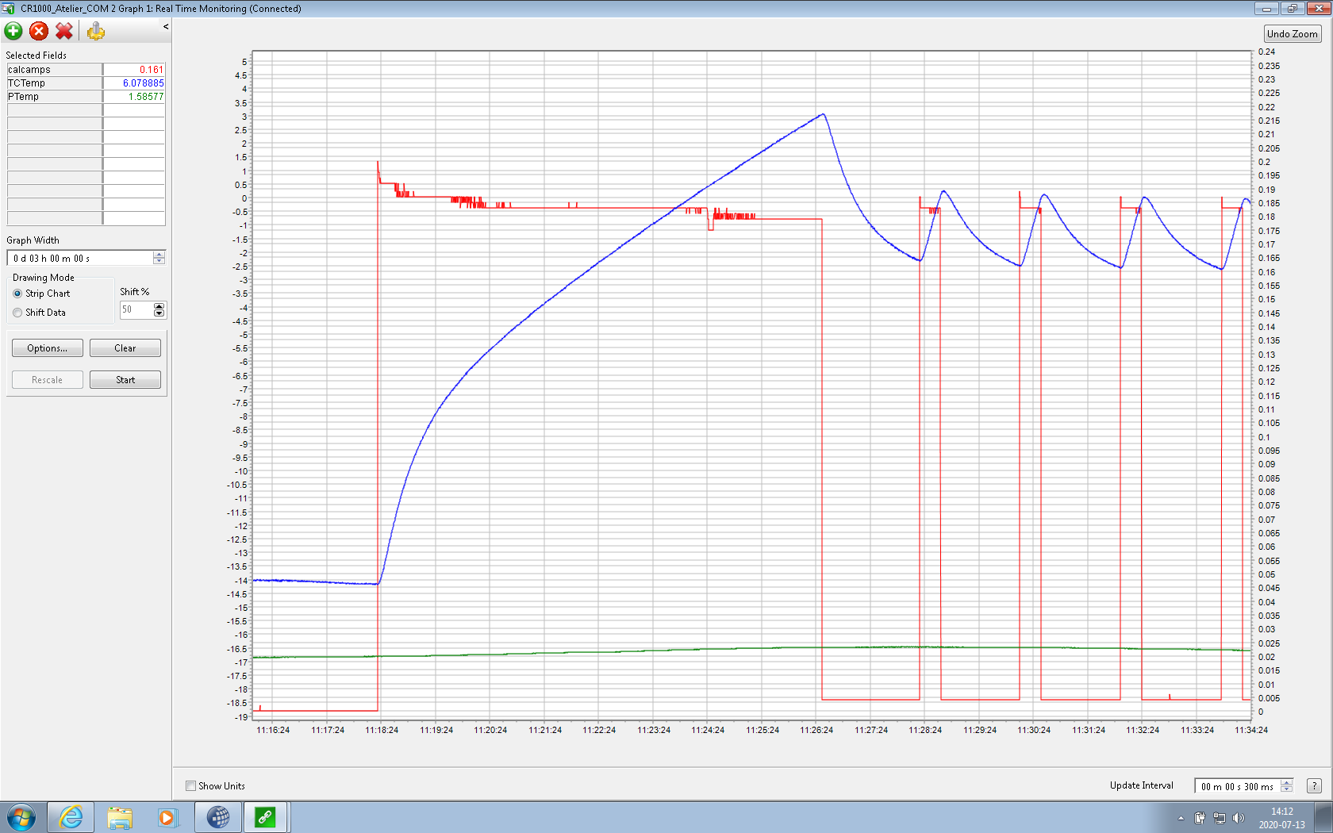
Extras/HW/Testings/recharge1.png
