Simgag-MinEnv/DEHCam/Extras/HW/Testings/recharge2.png

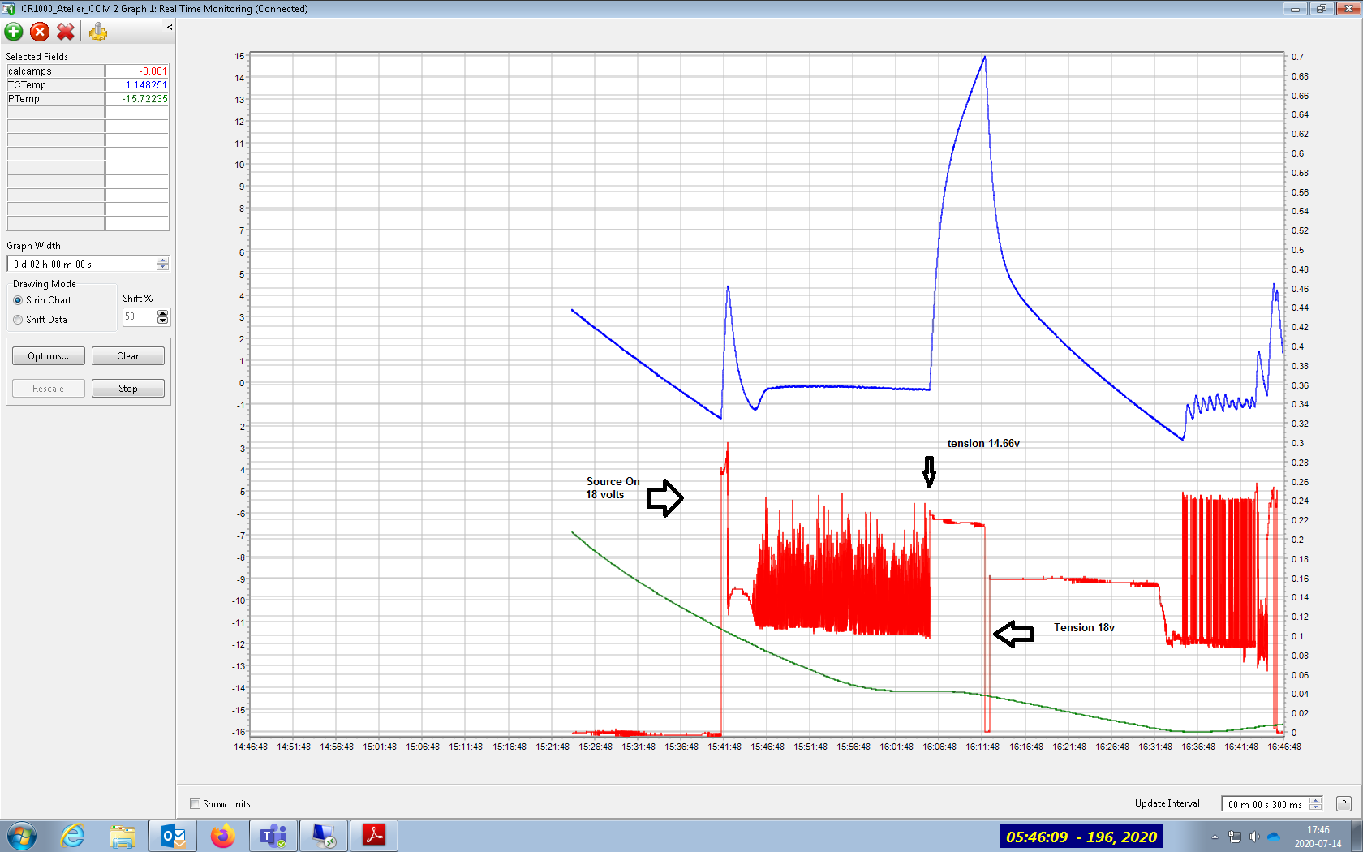
Extras/HW/Testings/recharge2.png
