Simgag-MinEnv/DEHCam/Extras/HW/Testings/recharge.png

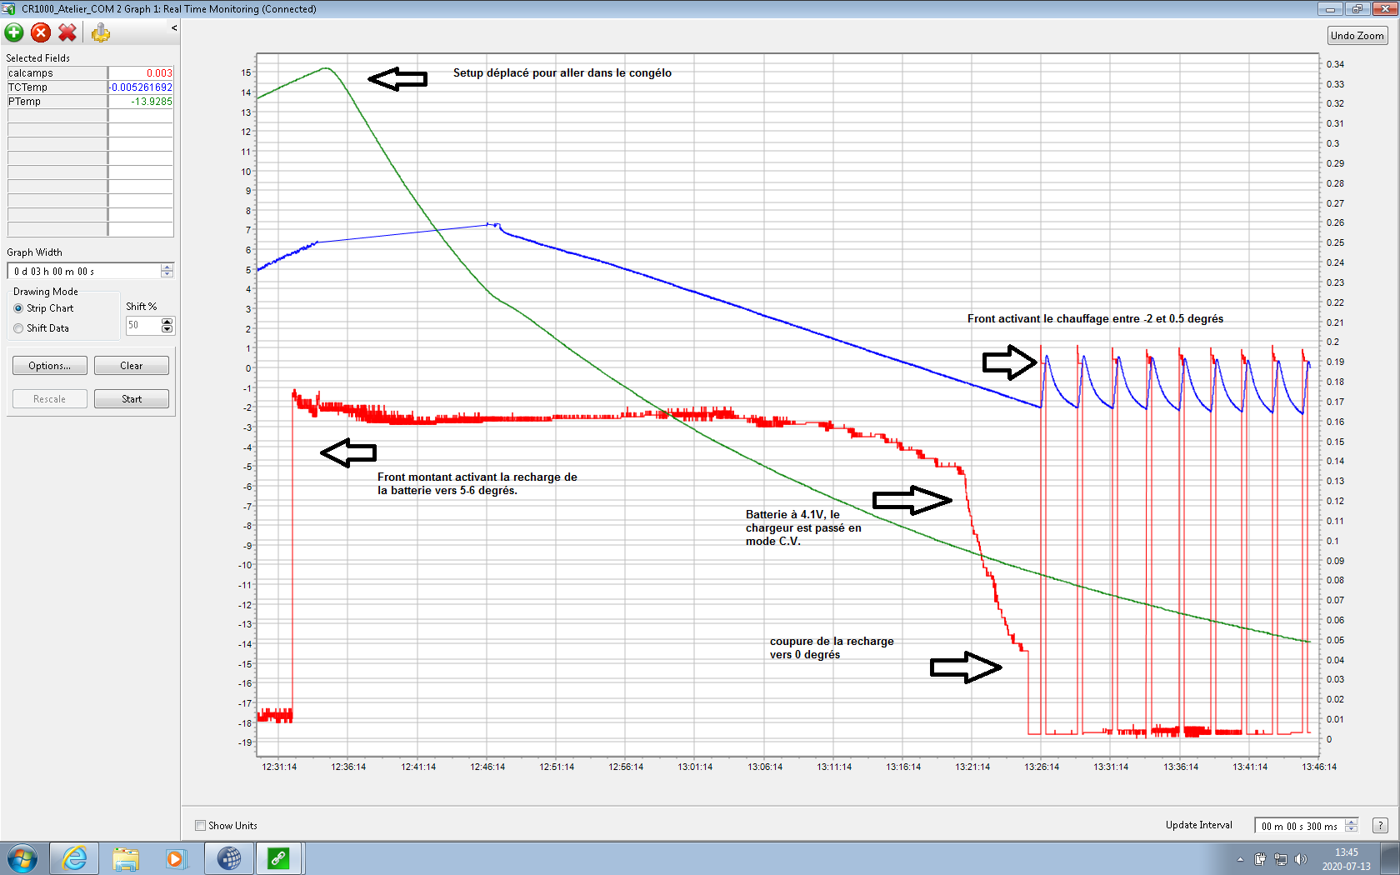
Extras/HW/Testings/recharge.png
