Simgag-MinEnv/DEHCam/Extras/Man/Fr/img/verifSD.png

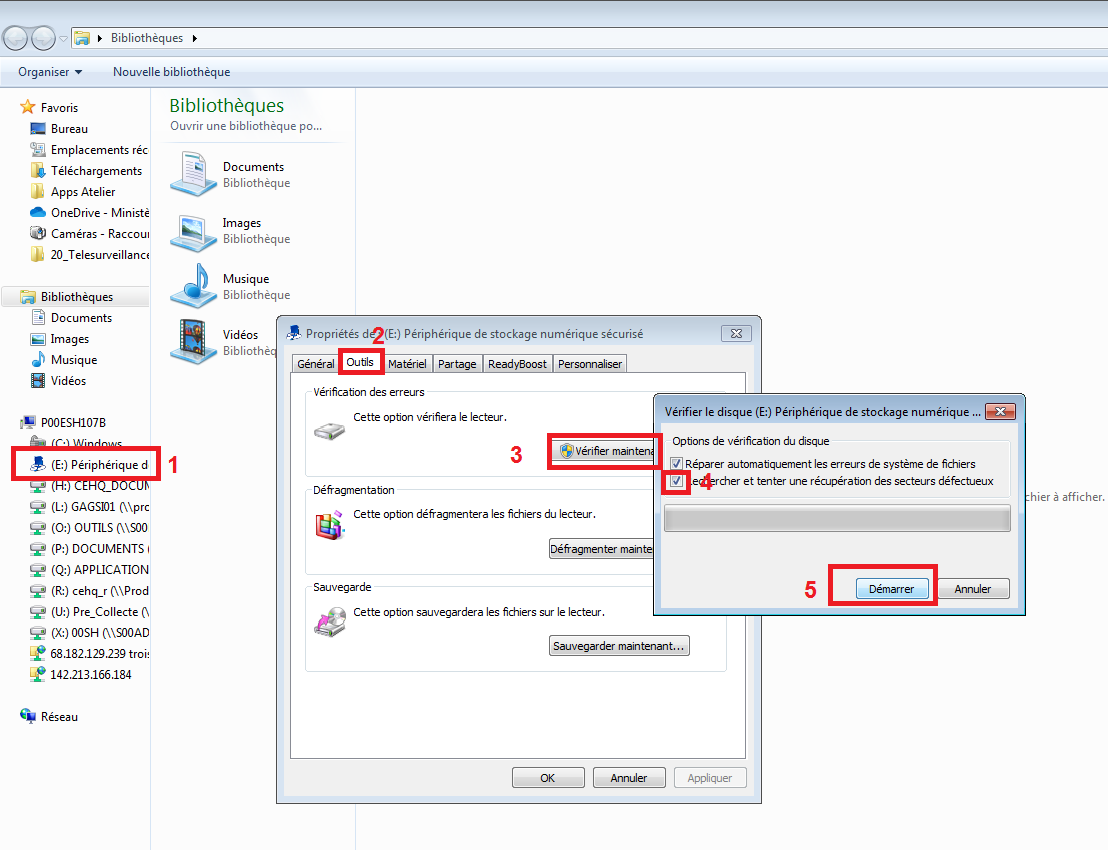
Extras/Man/Fr/img/verifSD.png
