Simgag-MinEnv/DEHCam/(threads)

Thread 4 (2021-03-05):

MakeDir Fail fault récurrent sur certain board

Simgag-MinEnv, 2021-03-05:

Simgag-MinEnv, 2021-05-13:
Réglé avec SdFat

Closed 2021-05-13.

Thread 5 (2021-03-05):

SD init erreur en OS 2.0.0

Simgag-MinEnv, 2021-03-05:

Simgag-MinEnv, 2021-05-13:
L'utilisation de la nouvelle librairie SdFat règle le problème. ATTENTION: SD.h n'est pas compatible avec OS>2.0.0 donc tout firmware compilé en 1.5.2 aura des problème d'initialisation SD sur un appareil OS>2.0.0

Closed 2021-05-13.

Thread 6 (2021-04-13):

Cell signal timeout trop long/ ne finit pas

Simgag-MinEnv, 2021-04-13:

Simgag-MinEnv, 2021-04-14:
on entre dans la séquence en observant la valeur de "wakeupReason" et on sortait en effectuant un goto loop qui réévaluait cette condition, le wakeup était le même et on entrait donc à nouveau dans la loop... à l'infini. J'ai remplacé les Goto Loop par des system.reset()

Closed 2021-05-13.

Thread 7 (2021-05-13):

Le nom de l'image de la commande ForcePic est la fin et non au début

Simgag-MinEnv, 2021-05-13:
ex: 043102_202105Test1.jpg au lieu de Test1_202105141157.jpg

Simgag-MinEnv, 2021-05-13:
Du à la nature de la fonction "GrabPic" seul la terminaison du nom de fichier est passé en paramètre. Il faudrait changer complètement la fonction pour rendre cela possible. Vu qu'il s'agit d'une fonction de test pour la mise en marche je vais laisser ça comme ça.

Closed 2021-05-13.

Thread 11 (2021-05-19):

Fichier CONFIG.JSN dans mémoire flash intégrée

Simgag-MinEnv, 2021-05-19:
Les cartes SD ne sont pas parfaites et présentent parfois des erreurs. Il serait plus simple de récupérer la carte SD si la configuration de la caméra était enregistrée dans la mémoire FLASH de 4 MB intégrée au micro contrôleur plutot que sur la carte SD. Ceci permettrais également un fonctionnement sans carte SD.
