Simgag-MinEnv/DEHCam/Extras/HW/PCB/REVB/Drawings/SCH E-HX00-0-0-B PCB 16-MARS-2021.pdf

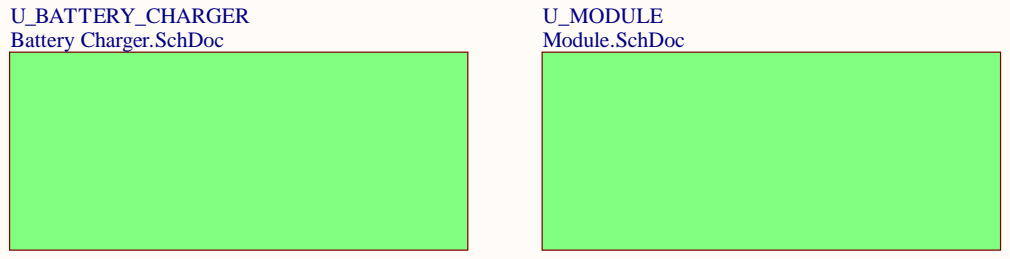
[picture p53: page 1]

DEHCam © 2021 by Explora and MELCC is licensed under CC BY 4.0

Ce document a été conçu par Explora Technologies pour
MELCC
Il est la propriété exclusive de
et ne peut pas être utilisé ou reproduit, partiellement ou en
entier, sans le consentement écrit de

This document has been developed by Explora Technologies for
It is the exclusive property of MELCC
and it may not be used or reproduced in whole or part,
except with the express written consent of MELCC

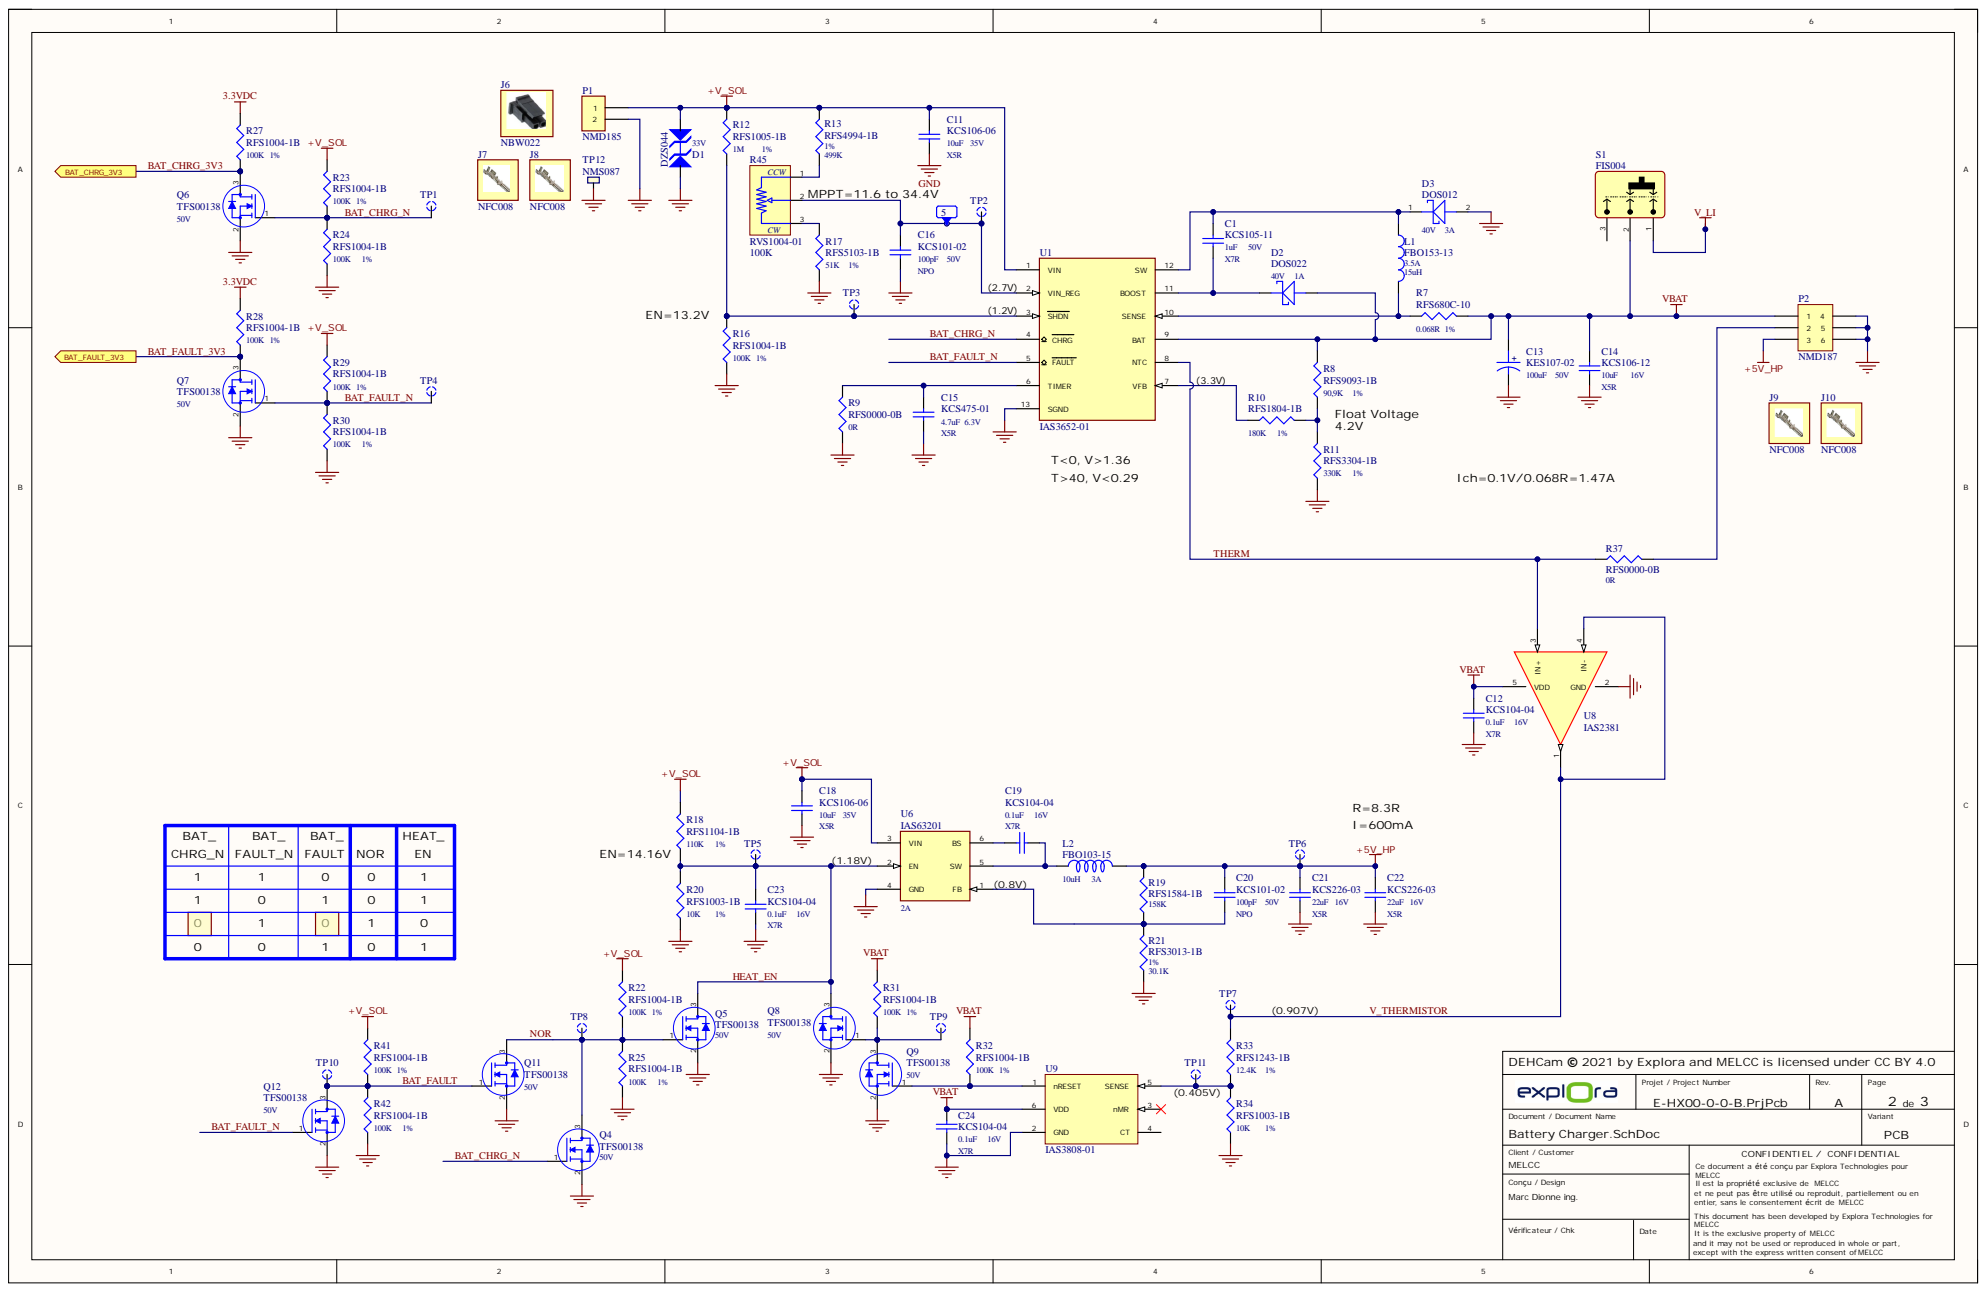
[picture p54: page 2]

DEHCam © 2021 by Explora and MELCC is licensed under CC BY 4.0

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

This document has been developed by Explora Technologies for

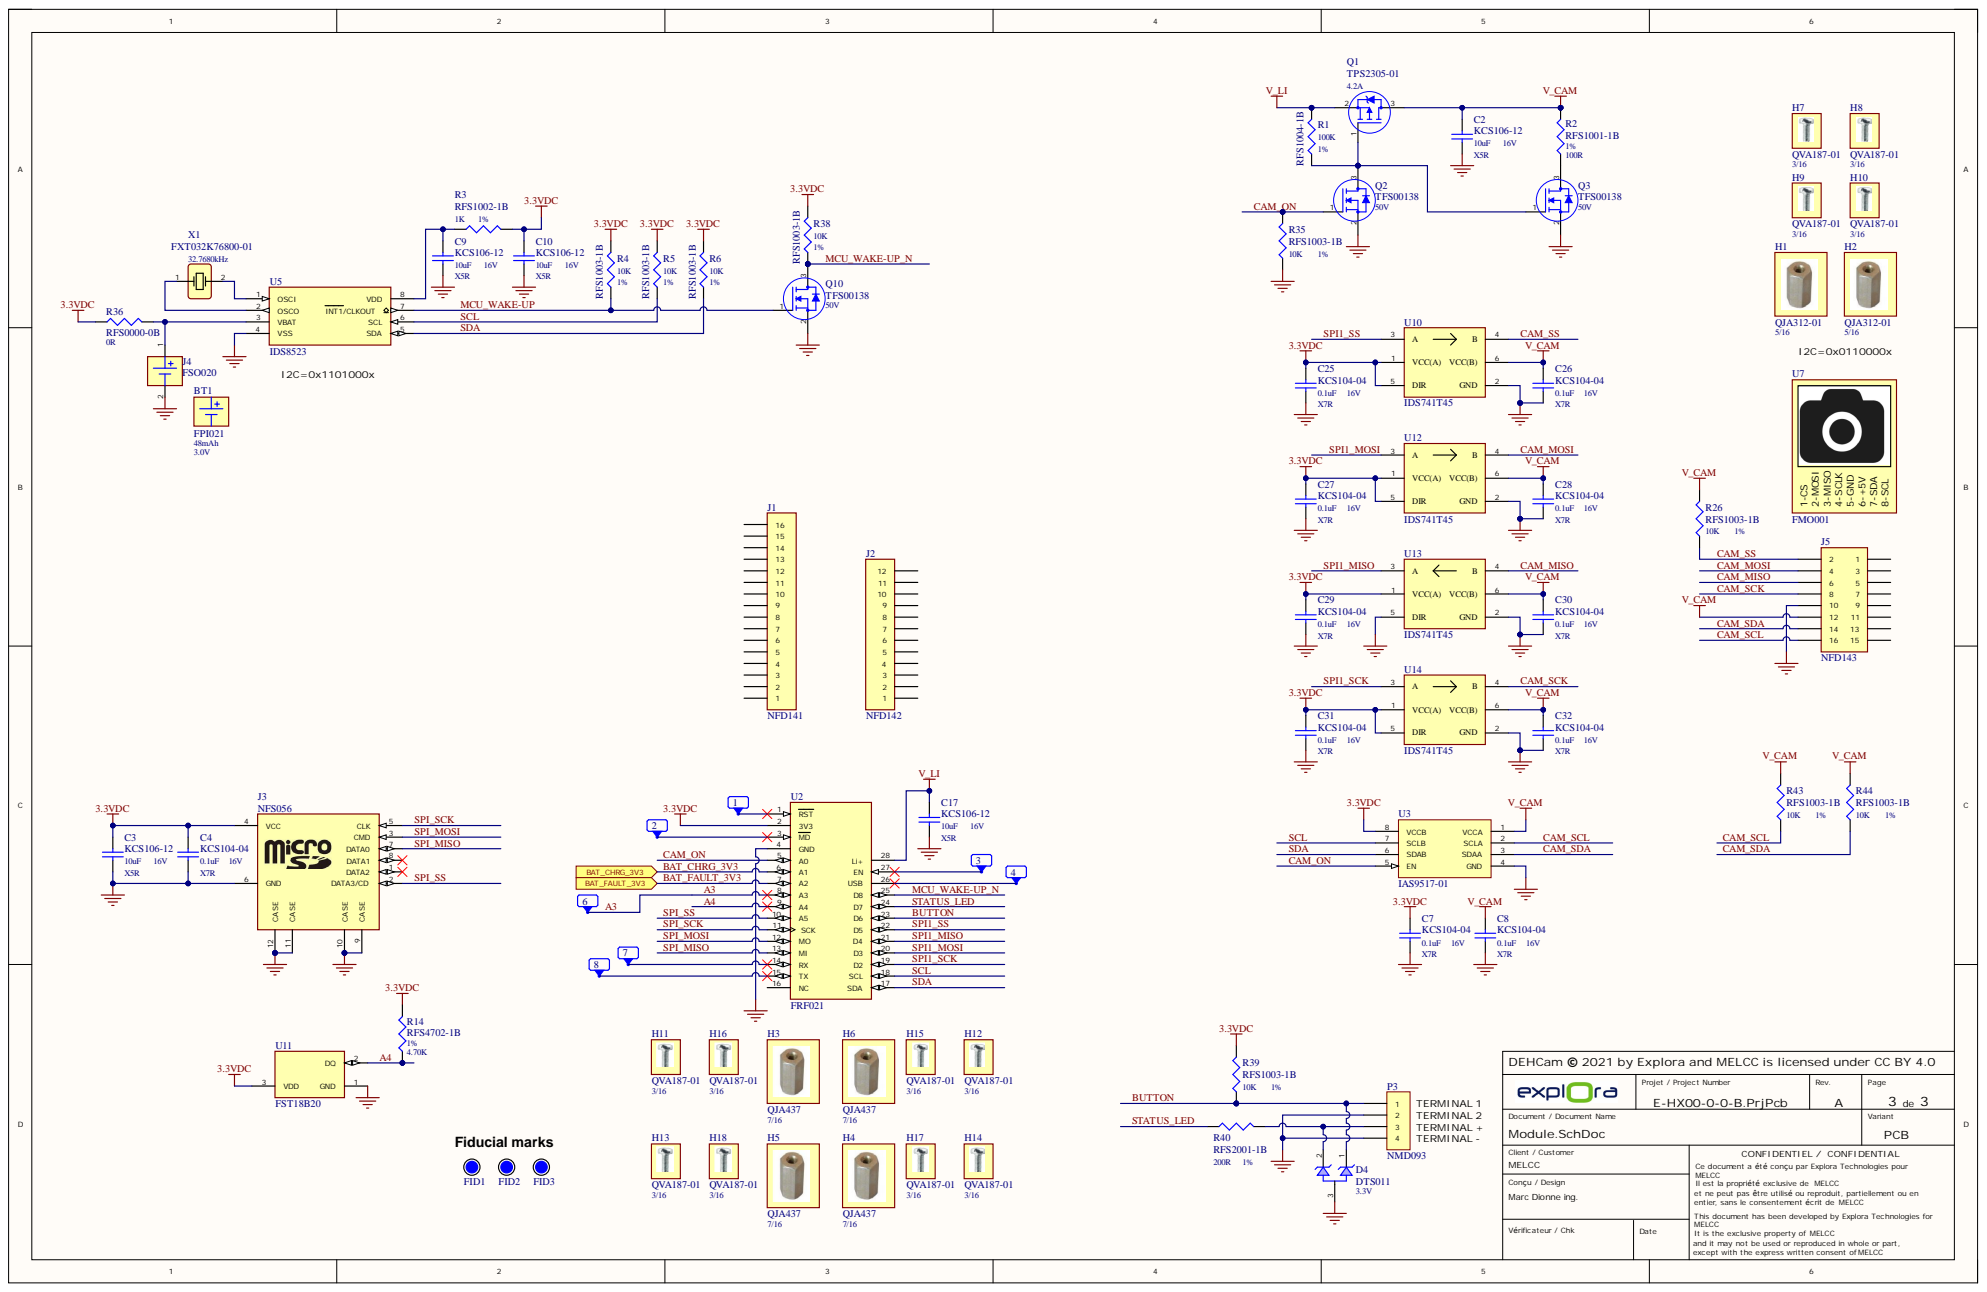
[picture p55: page 3]

DEHCam © 2021 by Explora and MELCC is licensed under CC BY 4.0

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

This document has been developed by Explora Technologies for
