Simgag-MinEnv/DEHCam/Extras/HW/PCB/REVB/Drawings/SCH E-HX00-0-0-B R01 25-JAN-2021.pdf

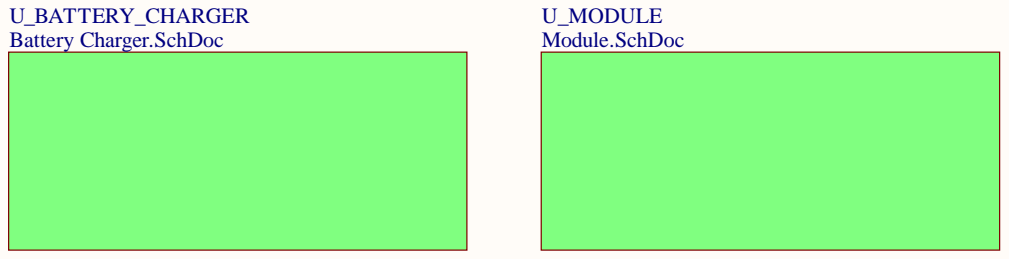
[picture p58: page 1]

Ce document a été conçu par Explora Technologies pour
Il est la propriété exclusive de
et ne peut pas être utilisé ou reproduit, partiellement ou en
entier, sans le consentement écrit de

This document has been developed by Explora Technologies for
It is the exclusive property of *
and it may not be used or reproduced in whole or part,
except with the express written consent of*

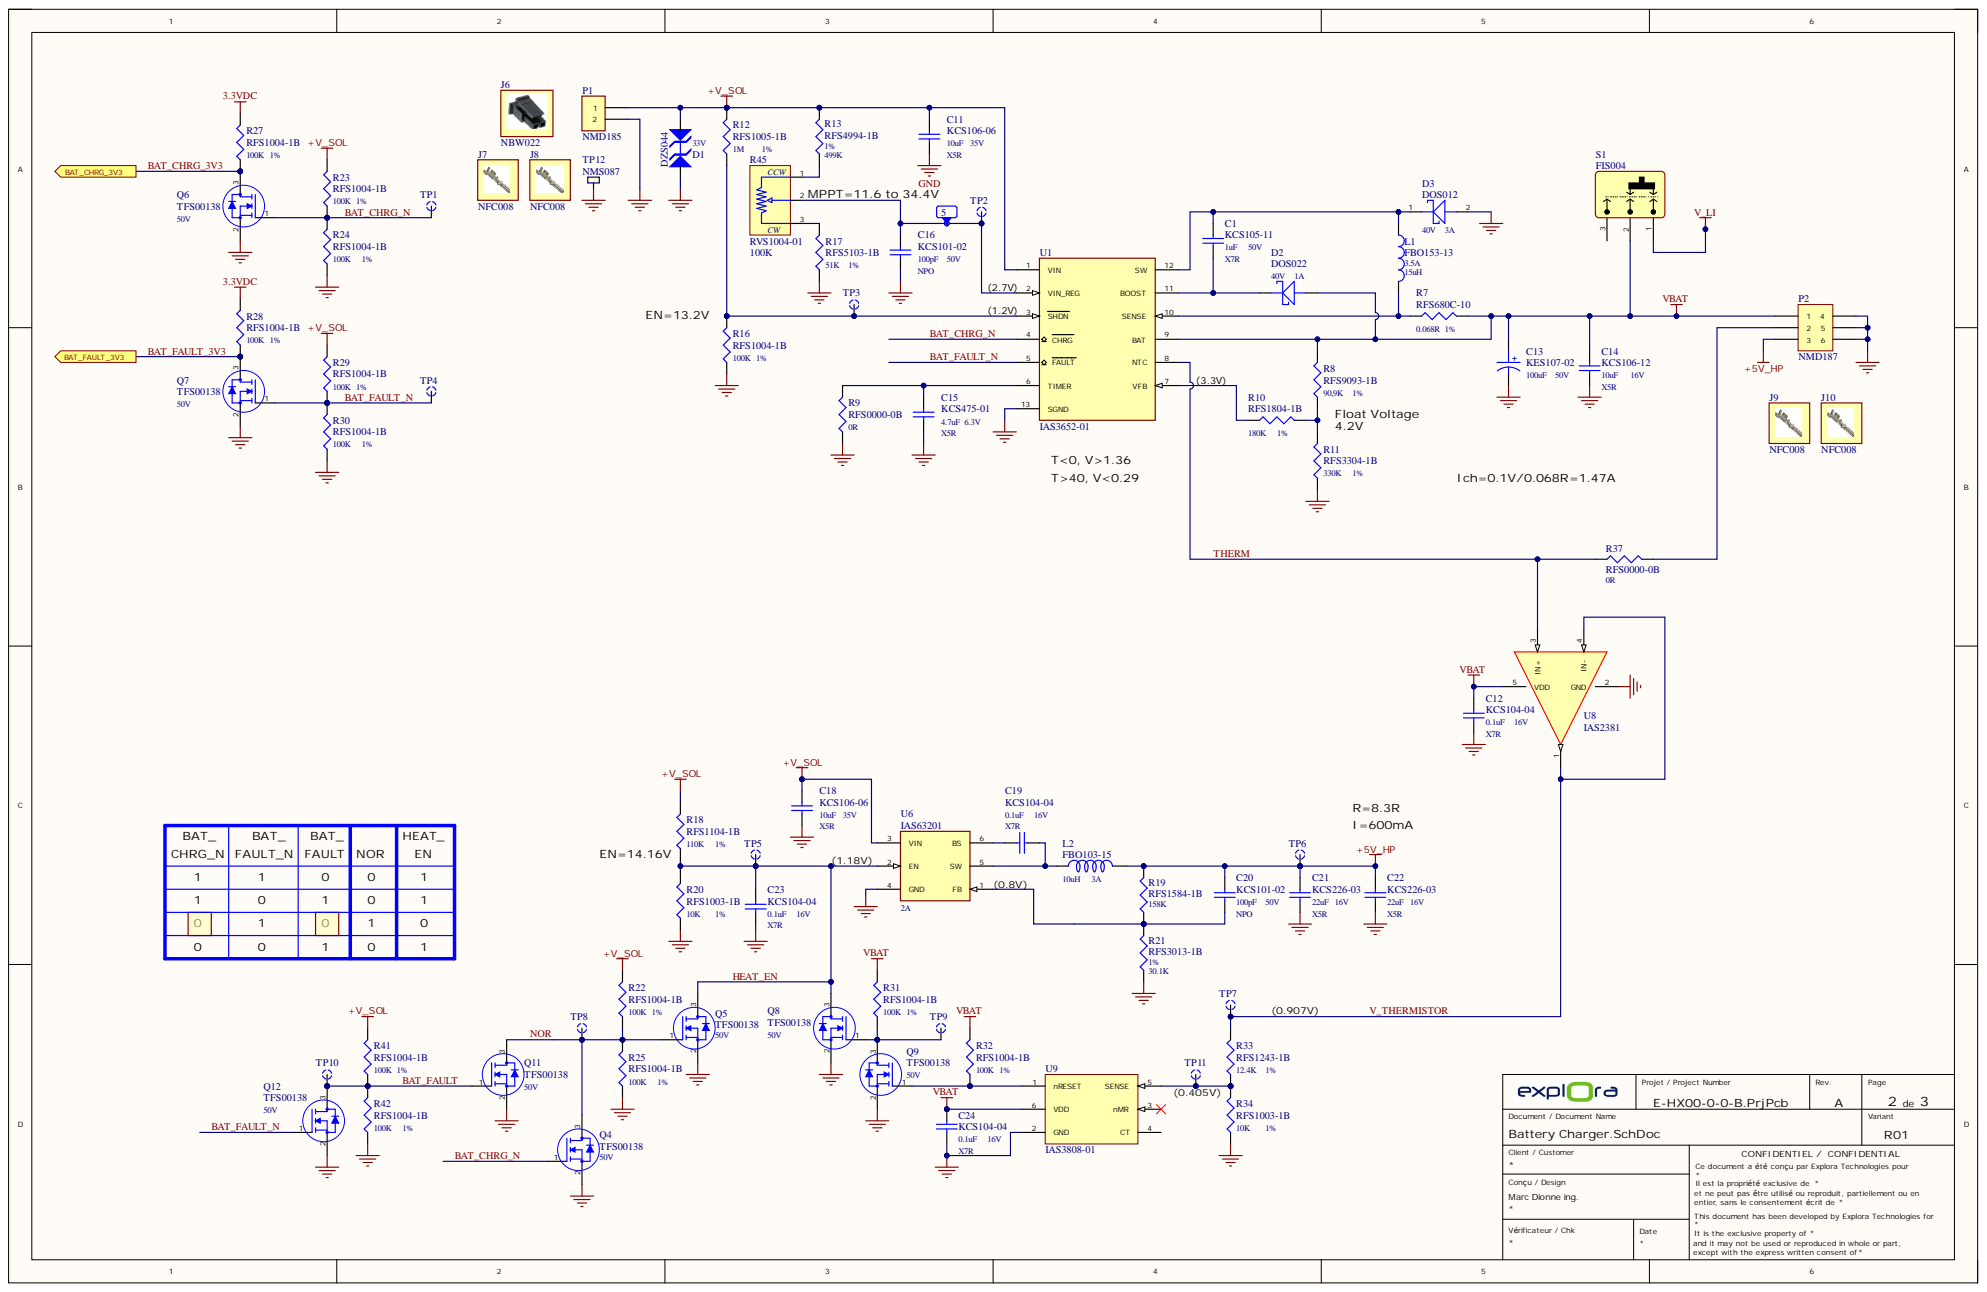
[picture p59: page 2]
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

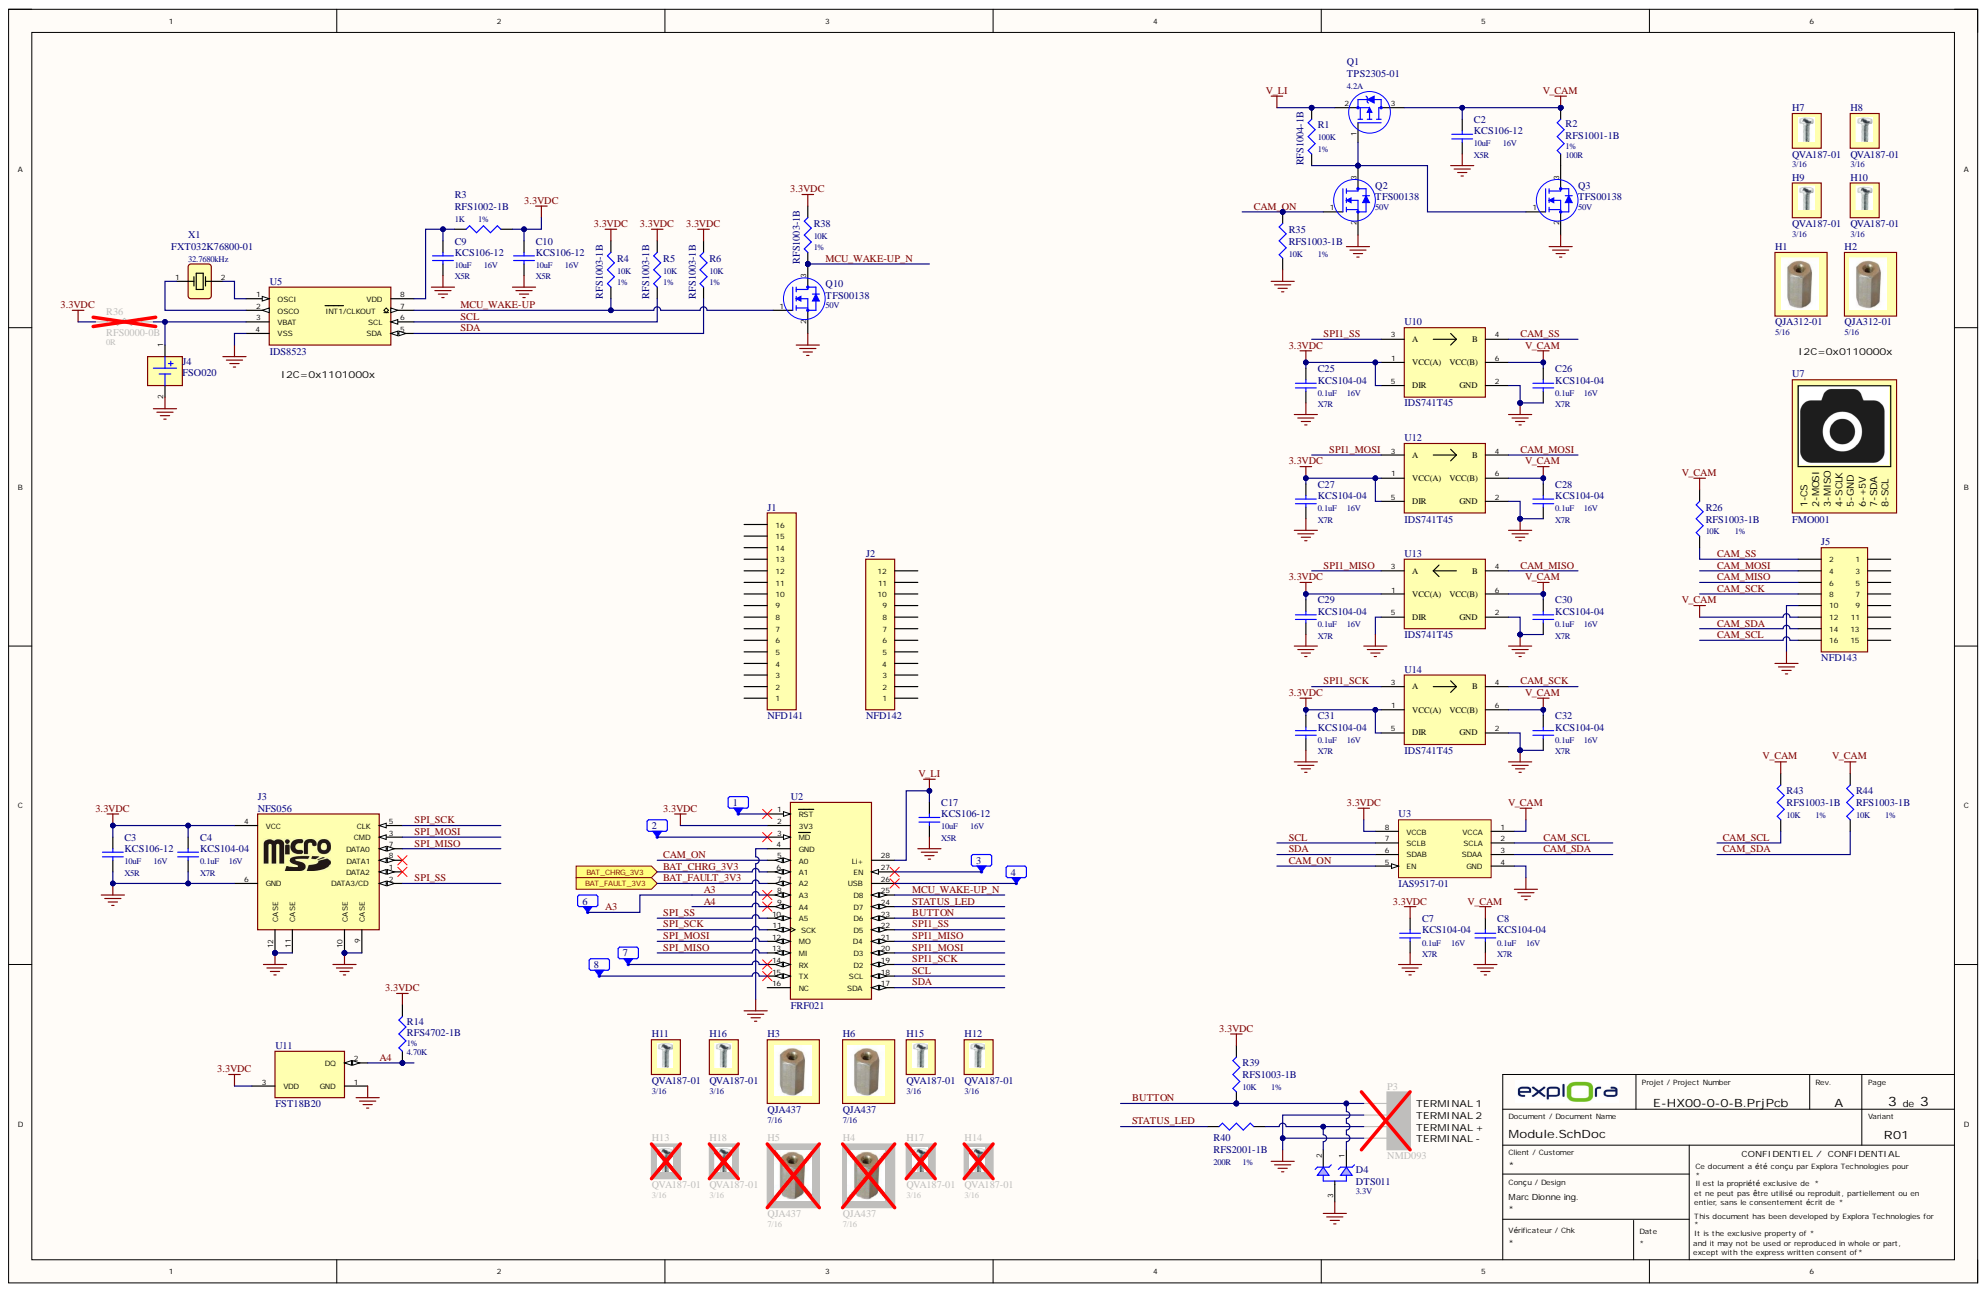
[picture p60: page 3]
