Simgag-MinEnv/DEHCam/Extras/HW/PCB/REVA/SCH E-HX00-0-0-A 08-JUIN-2020.pdf

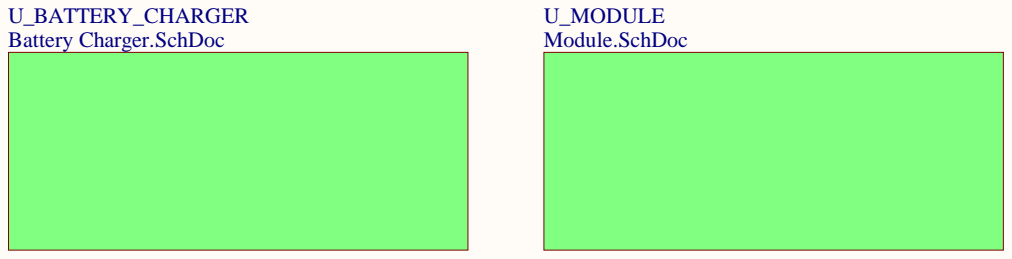
[picture p61: page 1]

Ce document a été conçu par Explora Technologies pour
Il est la propriété exclusive de
et ne peut pas être utilisé ou reproduit, partiellement ou en
entier, sans le consentement écrit de

This document has been developed by Explora Technologies for
It is the exclusive property of *
and it may not be used or reproduced in whole or part,
except with the express written consent of *

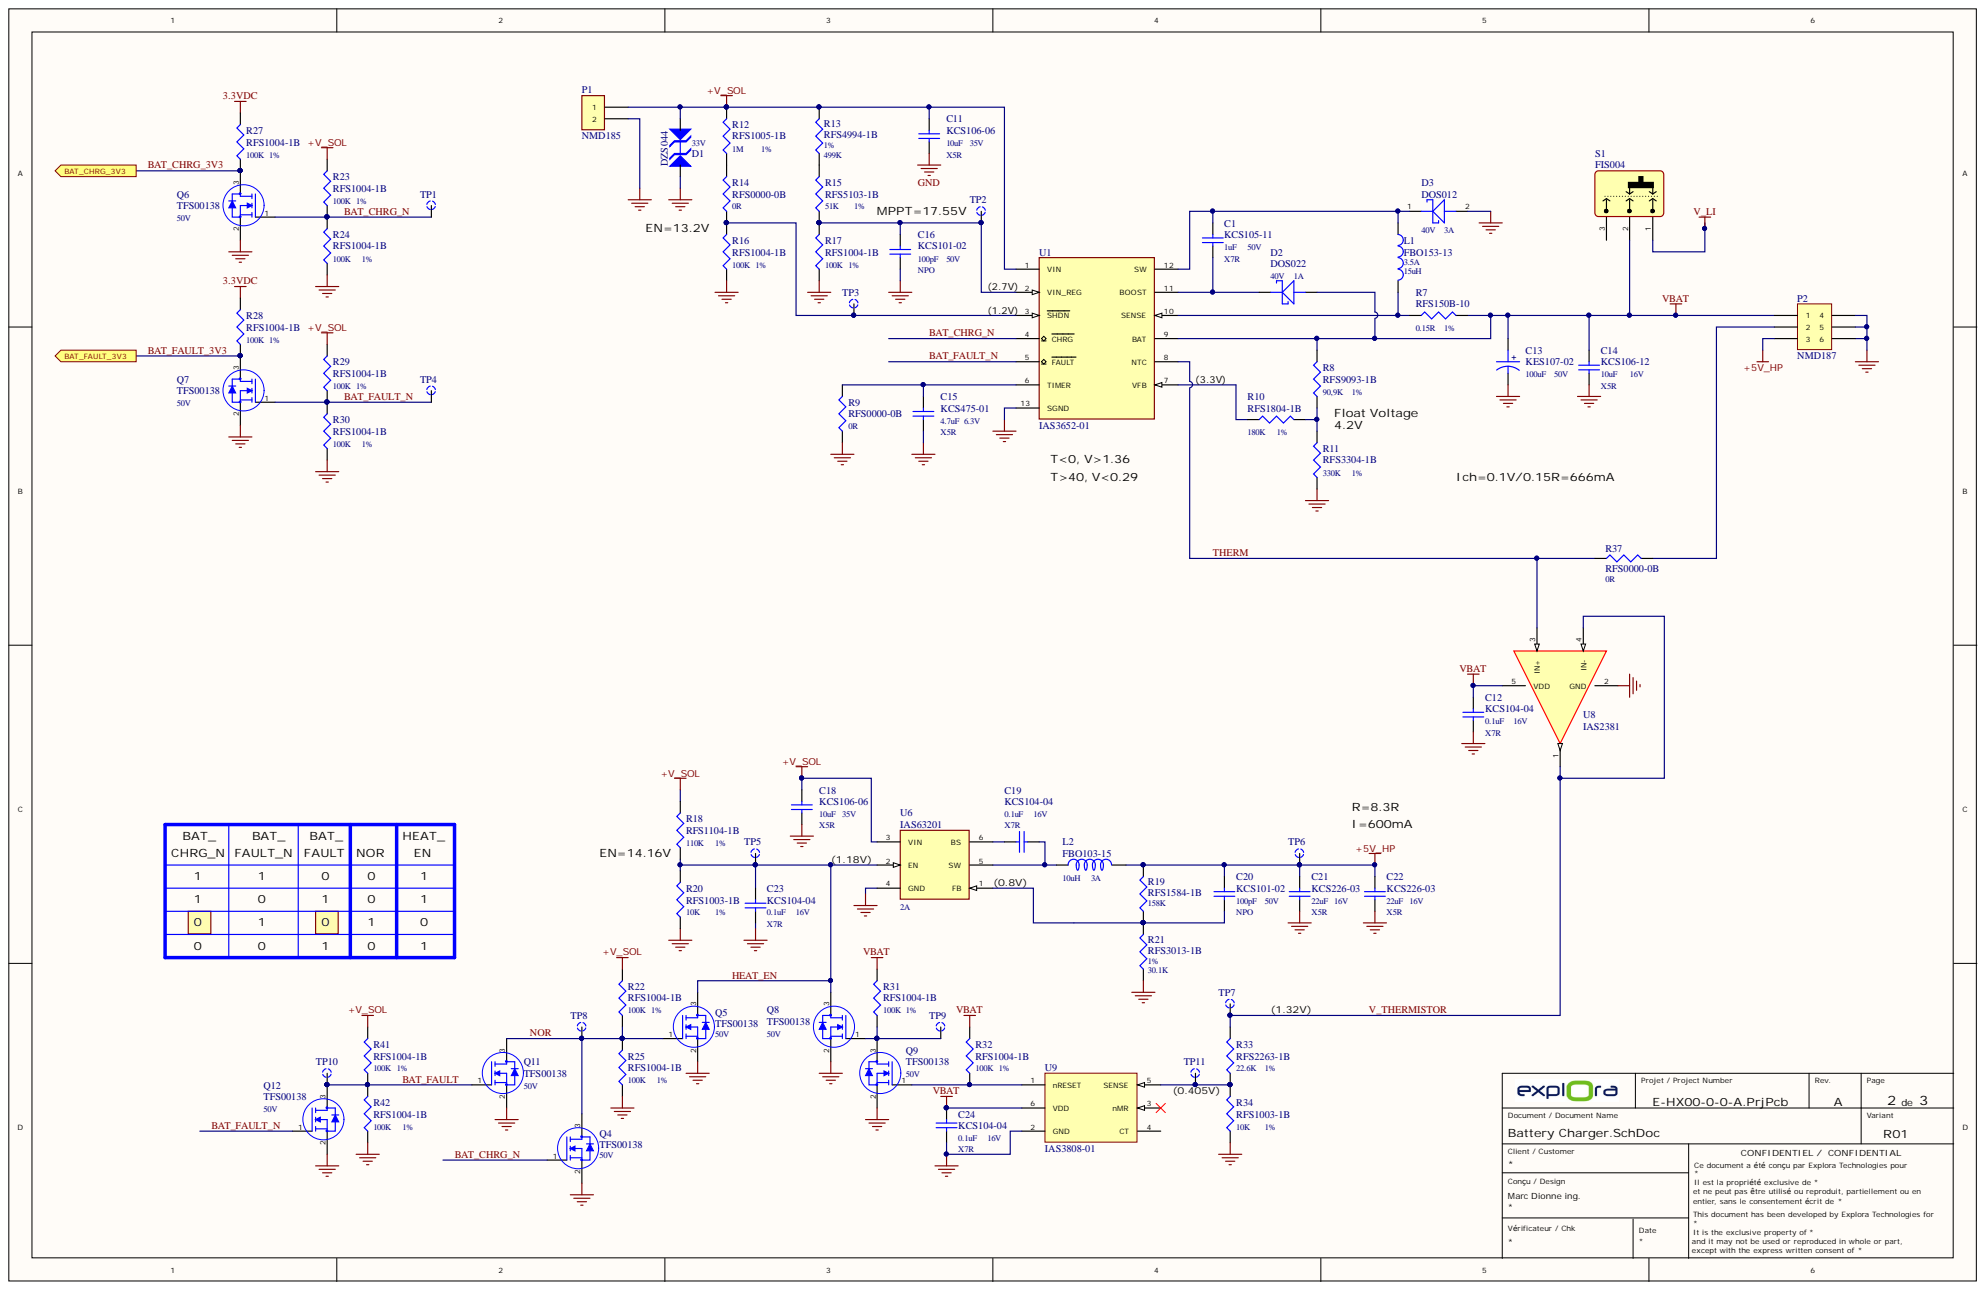
[picture p62: page 2]
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

This document has been developed by Explora Technologies for

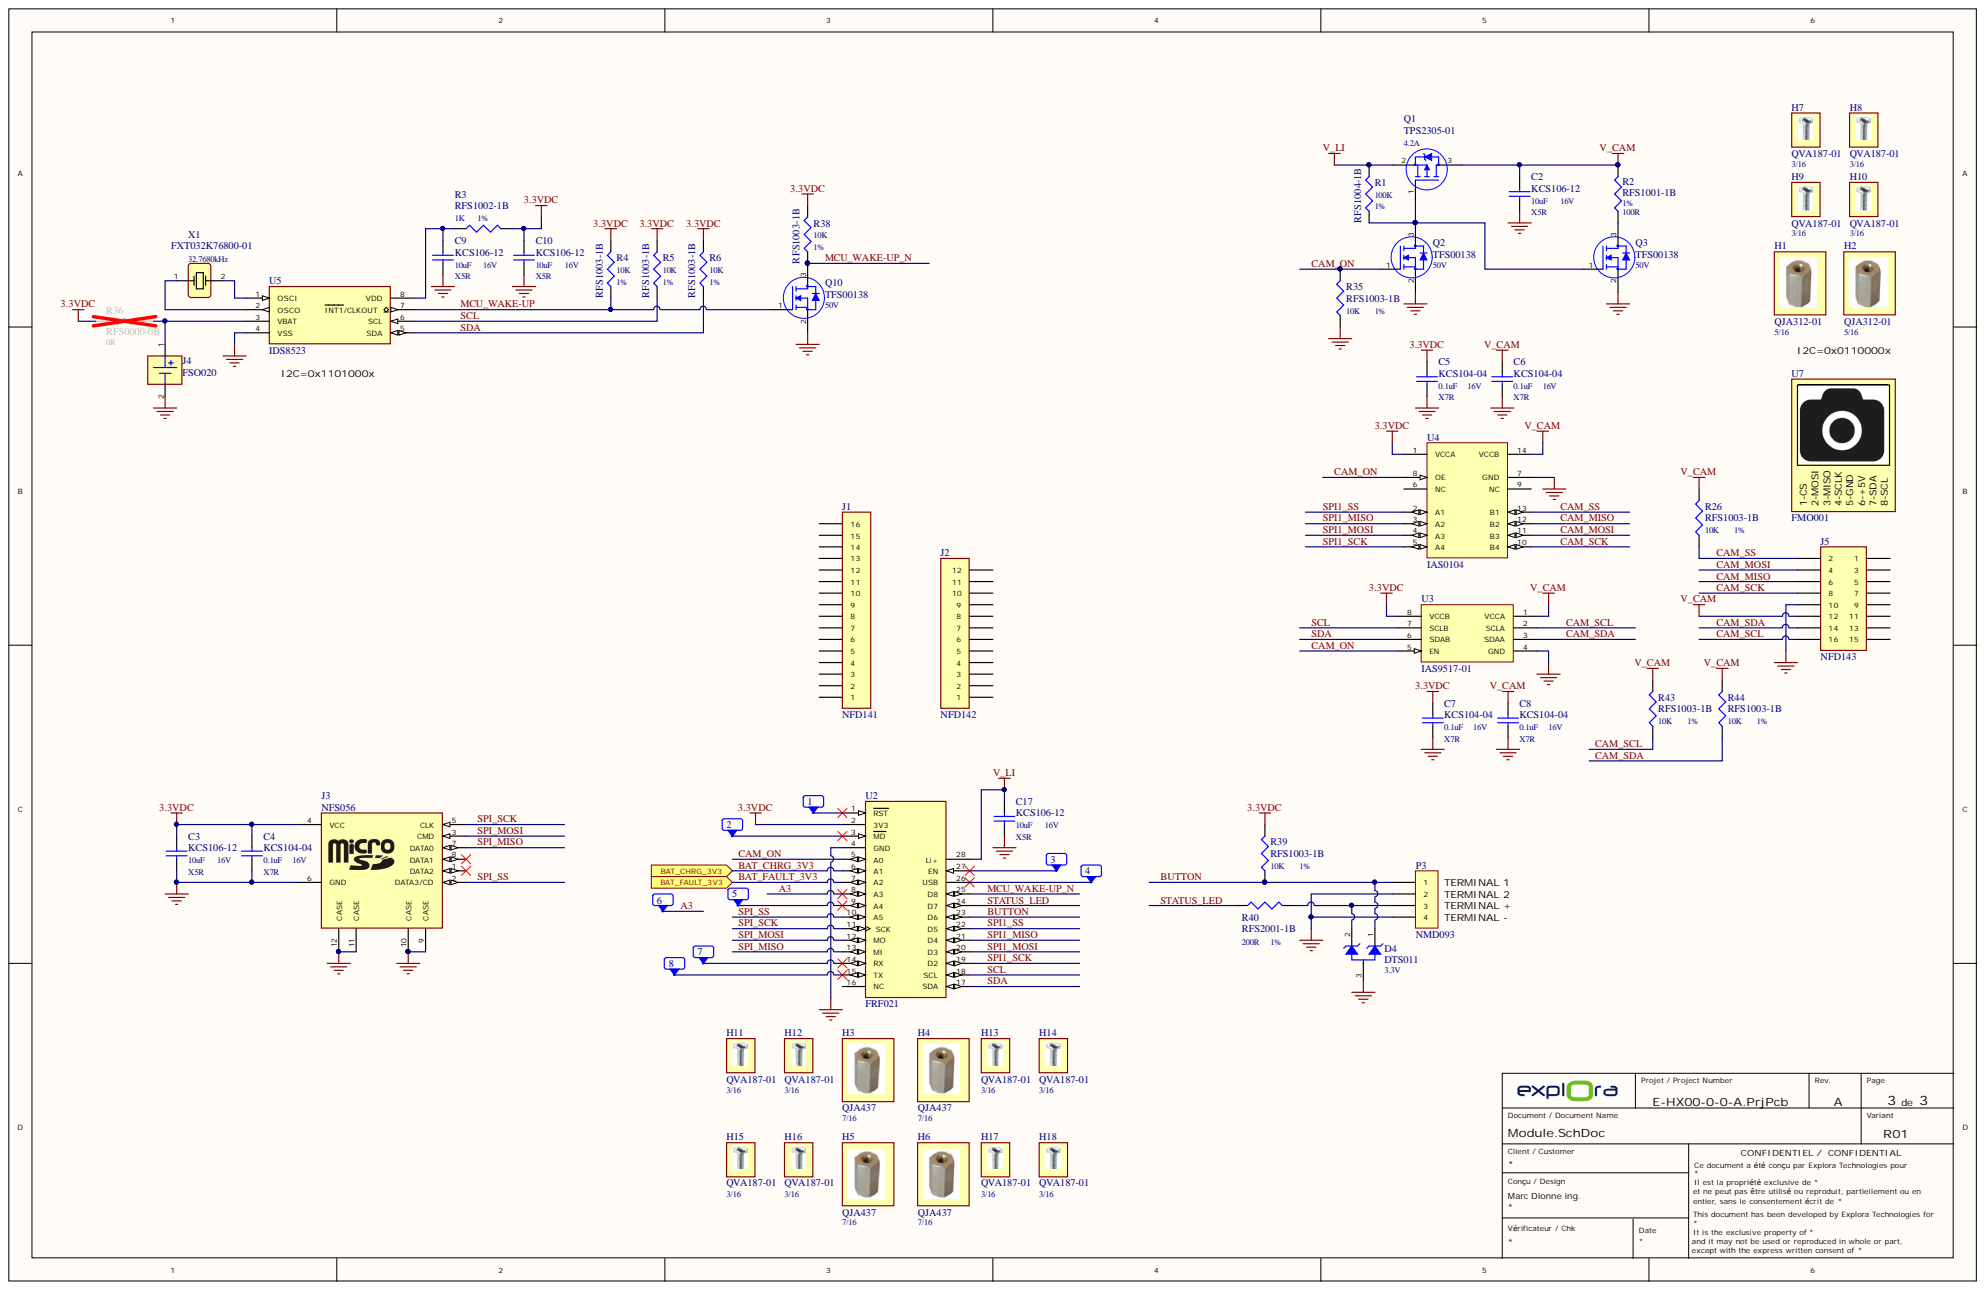
[picture p63: page 3]
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

This document has been developed by Explora Technologies for
