Simgag-MinEnv/DEHCam/(commit log)

2020-09-11 1.431 - RC1
    [Bom_8071126.xlsx]
2021-03-10 2.0.0-RC1
    #5 #4
    [Bom_8071126.xlsx]
2021-03-16 Added HW info RevB
    [BOM HX000-0-0-B 2021-03-16.xlsx]
2021-03-16 removed TX delay
    La vitesse de transfert passe de 1200-1300 bps à >5000bps mais on doit attendre OS2.0.2 à cause du bug #2263 qui affecte OS2.0.1
    [DEHCam.ino]
